conrad907/DCADesign/Design 2/Design Review Package/Final Design Review Package/Schematics/STLs/Tilt_Motor_Mount_4235323/README.txt

Tilt Motor Mount by ATXHELI on Thingiverse: https://www.thingiverse.com/thing:4235323
