conrad907/DCADesign/Design 1/F22_CPE_4813_Assignment7_SymposiumPoster_Team14 (1).pptx

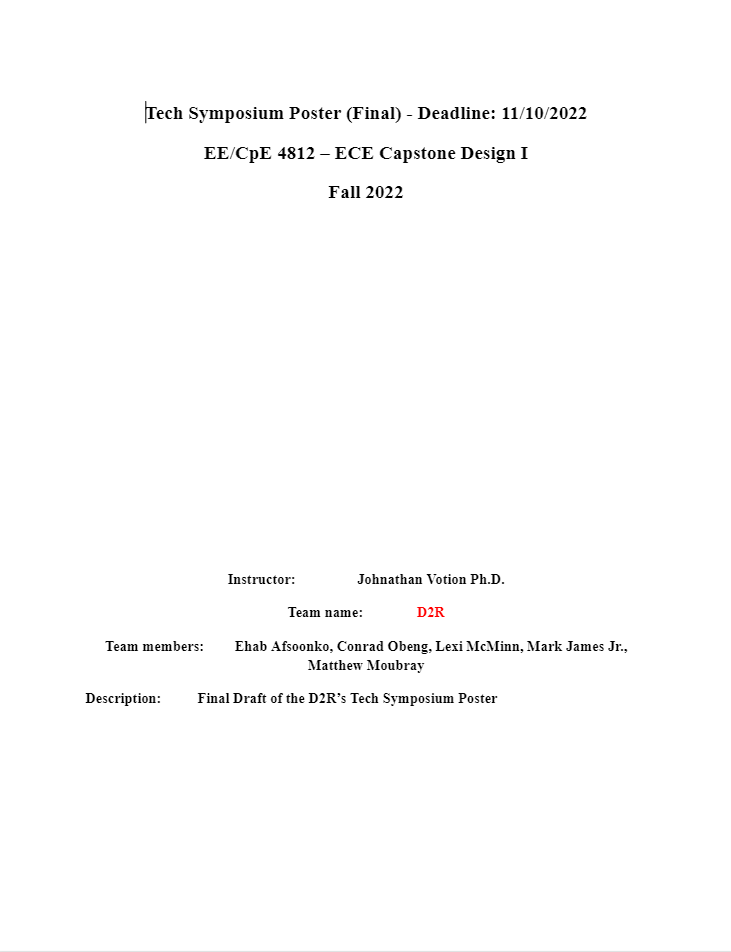
[picture p3: figure]

## Slide 2

Sponsor: USL Lab, UTSA
Ehab Afsoonko, Conrad Obeng, Lexi McMinn, Mark James Jr., Matthew Moubray

Alternative Transportation Modes for UAV Systems

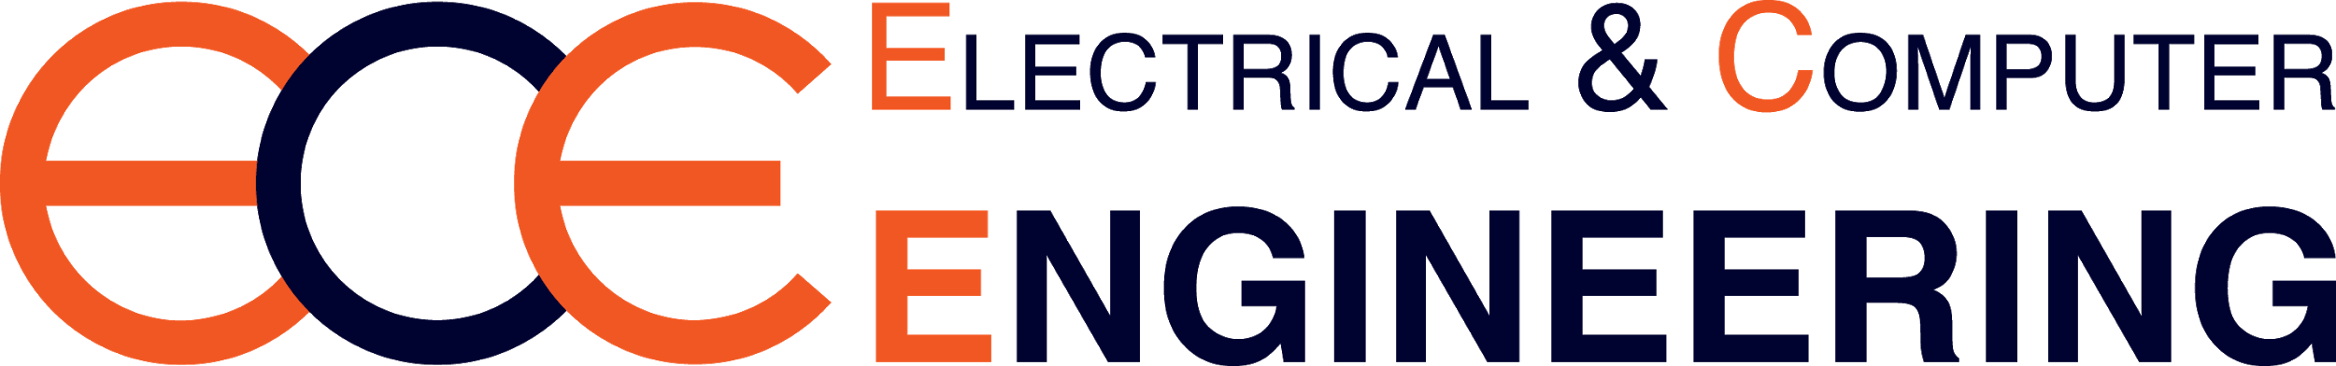
[picture p4: figure]

Abstract

This project aims to expand the number of vehicle transportation modalities traditionally associated with QuadCopter Drones, so that customers are not pigeon-holed into one method of transportation. Specifically, the project aims to bring VTOL Fixed-Wing and Rover transportation modes to a drone, allowing for longer flight times with less battery, and ground-based transportation, respectively.

Functional Block Diagram

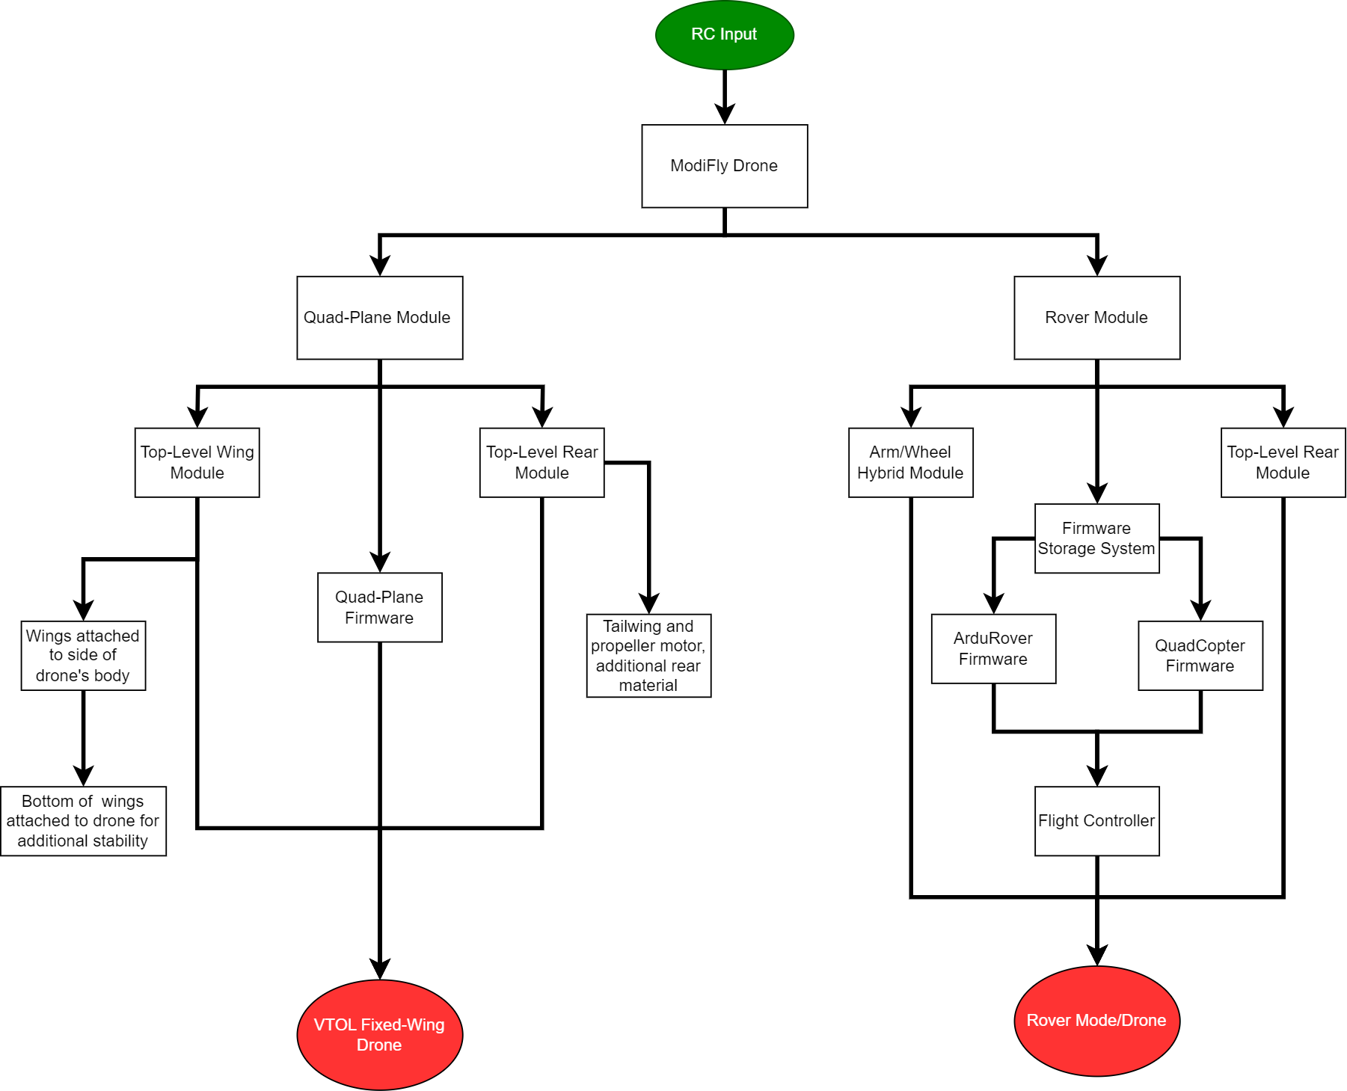
[picture p5: figure]

Components

- Flywoo Goku F745 Flight Controller
- ModiFly Drone Platform
- VTOL Fixed-Wing Module (Connector, wings, propeller, etc)
- Rover Module (Connector, wheels, etc)

Work Breakdown Structure

1. Month 1 - November:
  1. Download and familiarize with flight controller firmware
  2. Begin first design of Rover mode modules
2. Month 2 - December/January
  1. Prototype of Rover module
  2. First firmware modification test
  3. Implement Firmware swapping
3. Month 3 - February
  1. Begin prototyping Fixed-wing VTOL & firmware
  2. Continued development of Rover module
4. Month 4 - March
  1. Rover Module in final state, firmware close
  2. Fixed-Wing VTOL development continued
5. Month 5 - April to End
  1. Rover Module with switching capability implemented and fully document
  2. Fixed-wing VTOL module and firmware fully implemented

Need for Product

If an end-user only has a single UAV/UGV/unmanned system, that machine is limited to a single transportation modality. However, having separate re-attachable modules for different movement options allows the operator to change the functionality of the unmanned system without needing to purchase an additional system. Currently, most professional Fixed-Wing VTOL UAVs can cost anywhere from $1,000 to $20,000. By creating a Fixed-Wing VTOL and Rover re-attachable module, we enable the ModiFly Drone to be an extremely versatile and adaptable UAV versus it’s competitors, while also saving the consumer both time and money.

Fig. 7 Function Block Diagram

Design Concept

The goal is to add multiple reattachable-modules to an existing drone framework model with the intent to expand and improve the functionality. The primary module will add rover functionality that allows the drone to be able to land and switch to a ground-based transportation mode. The Rover module should be able to switch modes without needing the operator to be in close proximity, as well as preserve the flight or drive data between mode switches. The current solution is to design a new arm module that replaces the previous feet with a wheel, axle, and transmission assembly without adding too much weight to interfere with the flight capabilities. The second module will be a Fixed-Wing module that will allow for increased flight duration while retaining the Vertical Take-off and Landing capabilities already present on the base drone.
Major Features
- Air and ground transportation modes without operator’s physical interaction
- Fixed-wing VTOL Module
- Foldable wing design for Rover mode
- Flight/drive data consistency between mode changes

Software Flowchart

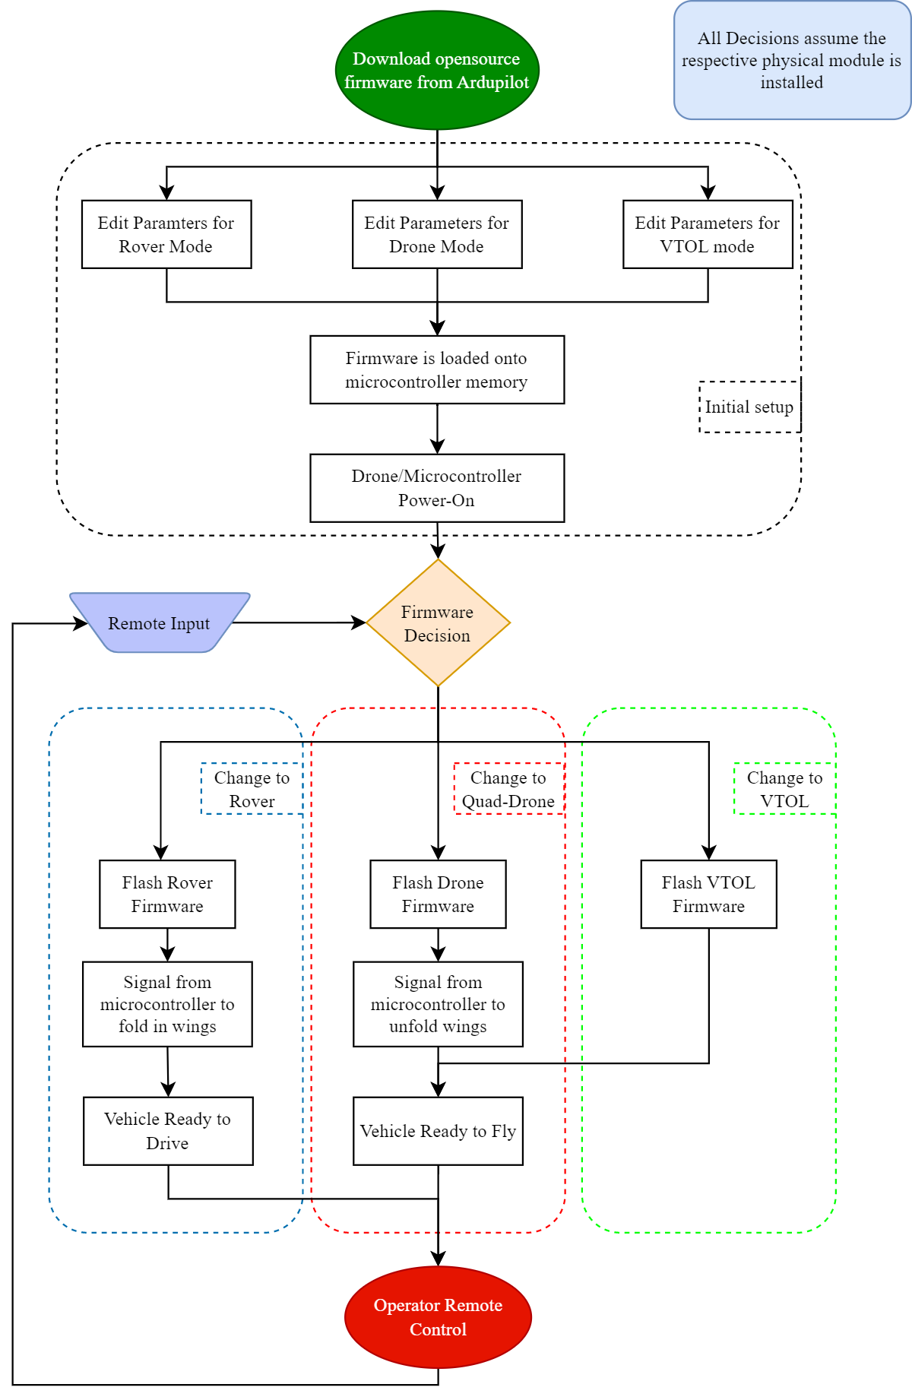
[picture p6: figure]
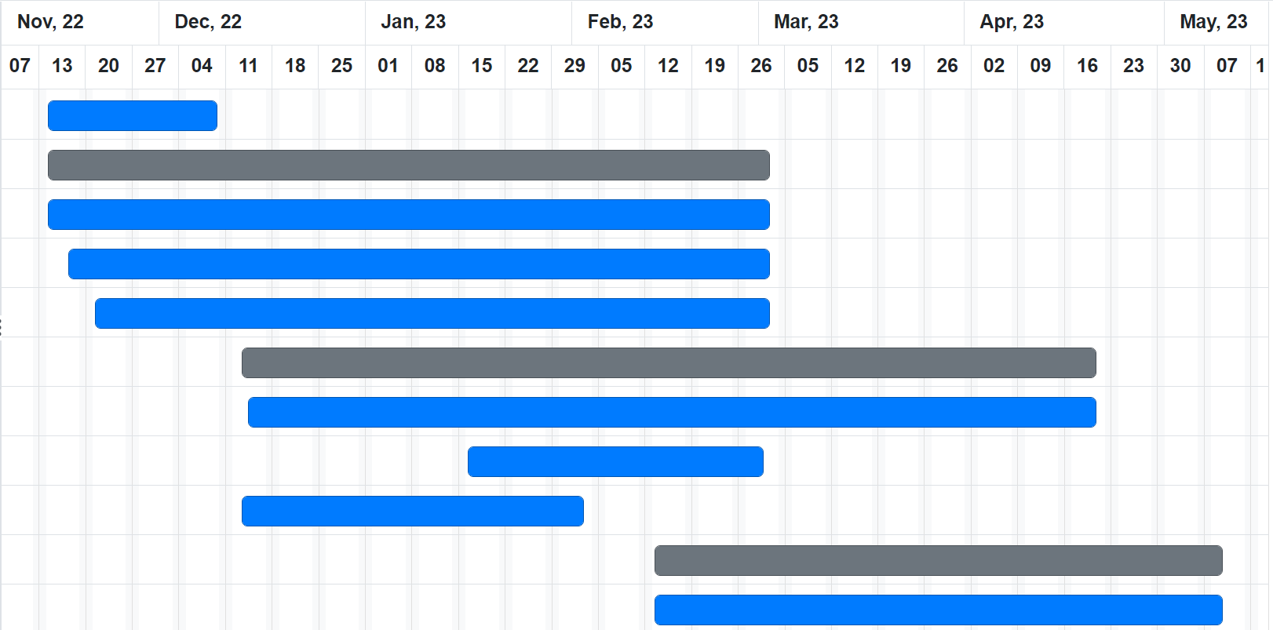
[picture p7: figure]
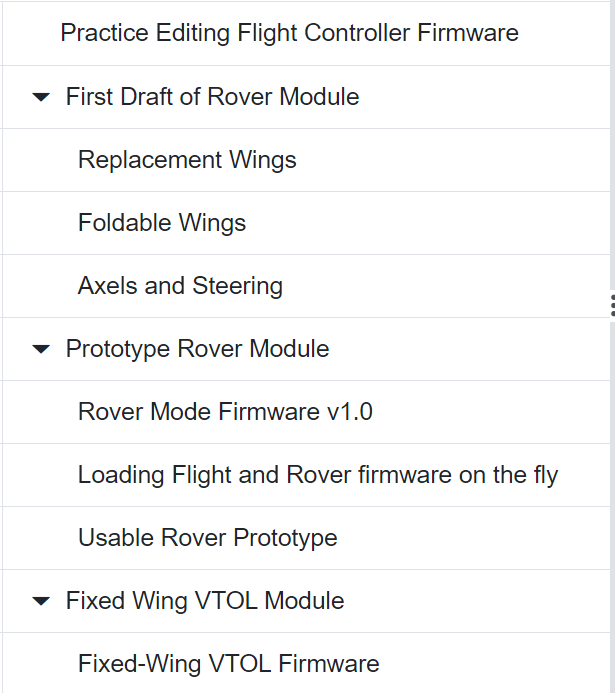
[picture p8: figure]

Fig. 9 Gantt Chart

Picture References

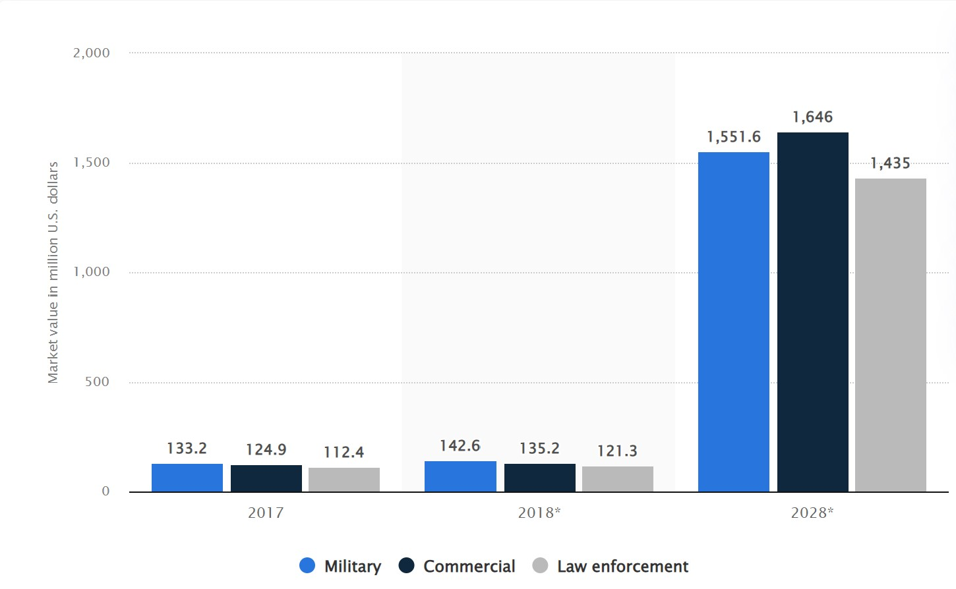
[picture p9: figure]

Fig. 1 Size of the global fixed-wing hybrid vertical take-off and landing (VTOL) UAVs market from 2017 to 2028, by end-user

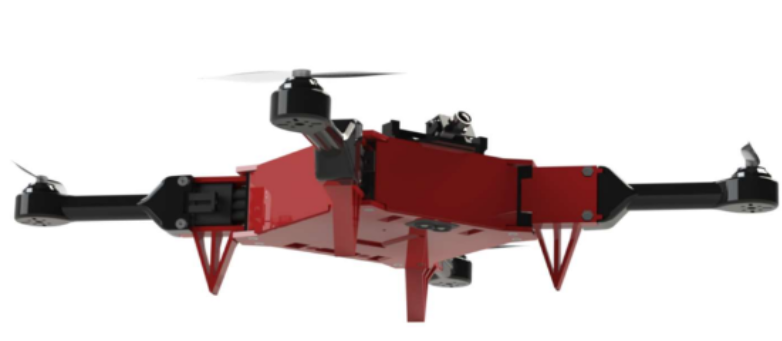
[picture p10: figure]

Fig. 2 Image of the ModiFly Drone platform

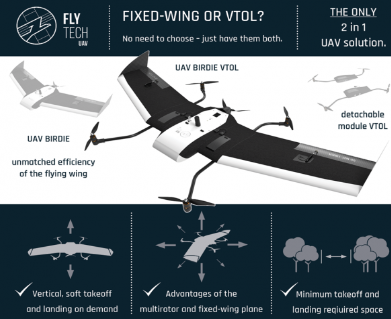
[picture p11: figure]
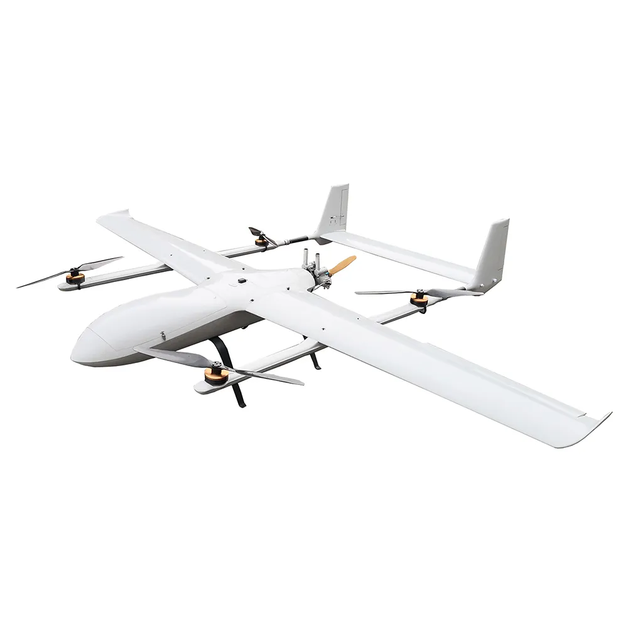
[picture p12: figure]

Acknowledgments

The Drone To Rover(D2R) team would like to give a special thanks to Dr. Yongcan Cao, ECE, USL Lab, UTSA, and Josh Barron for the technical and financial support of our project. We would also like to recognize the UTSA Makerspace, Student Success Center, and the UTSA ECE department faculty and staff for providing the resources, instruction and support related to this project.

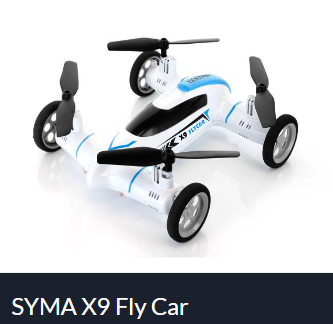
[picture p13: figure]

Fig. 3 (top) Flytech Birdie VTOL Module

Fig. 4 (bottom) SYMA X9 Fly Car

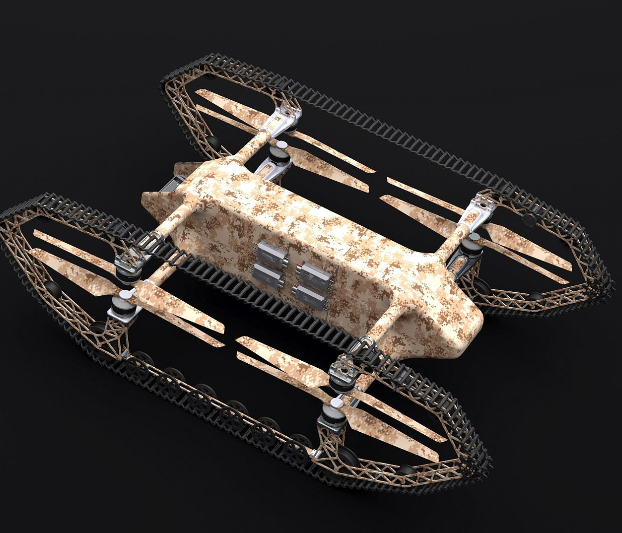
[picture p14: figure]

Fig. 5 (top) VTOL Fixed-Wing Drone

Fig. 6 (bottom) HUUVER Hybrid Drone

Fig. 8 Software Flowchart

## Slide 3

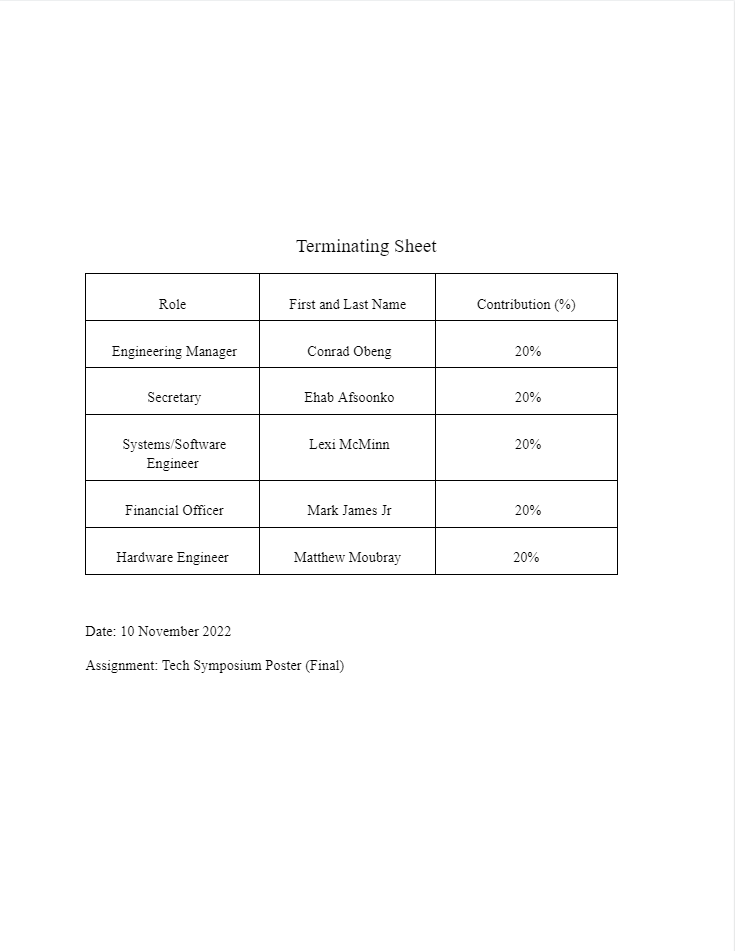
[picture p15: figure]
