conrad907/DCADesign/Design 2/Design Review Package/Final Design Review Package/Schematics/Copy of Airframe Schematic.pptx

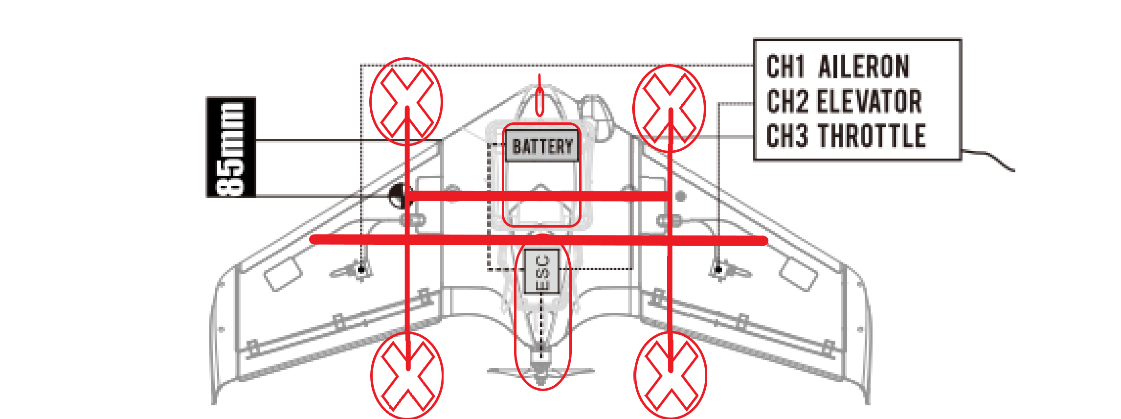
[picture p16: figure]

Team Design Additions
1. Propeller and boom assembly
2. Airspeed Sensor
3. ModiFly Base insert
4. Carbon Fiber poles and boom assembly joint connection
5. Carbon Fiber Poles for wing stability
6. Forward Propulsion ESC
7. Forward Propulsion Propellor

1.

2.

3.

4.

5.

6.

7.

## Slide 2

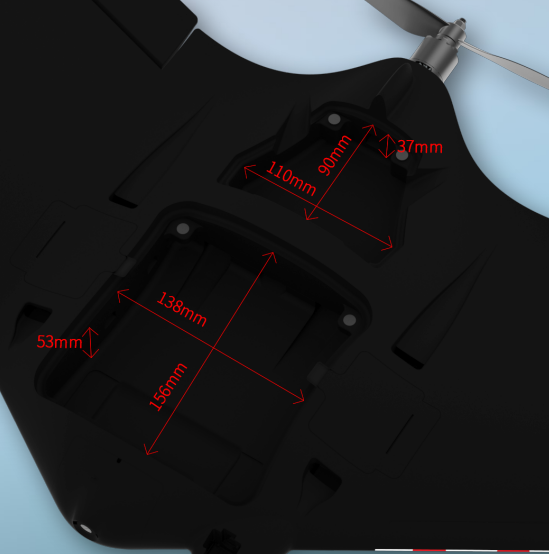
[picture p17: figure]
