conrad907/DCADesign/Cover Page.docx

DCA Project File

EE/CpE 4813 – ECE Capstone Design 2

Spring 2023

Instructor: Johnathan Votion Ph.D. & Professor August Allo

Team name: Drone Conversion Appliances (DCA)

Team members: Ehab Afsoonko, Conrad Obeng, Lexi McMinn, Mark James Jr., Matthew Moubray

Description: Folder Structure System for Design 1 and Design 2 Documentation
