conrad907/DCADesign/Design 1/Assignments/ArduRover High-Level Diagram.drawio (1).pdf

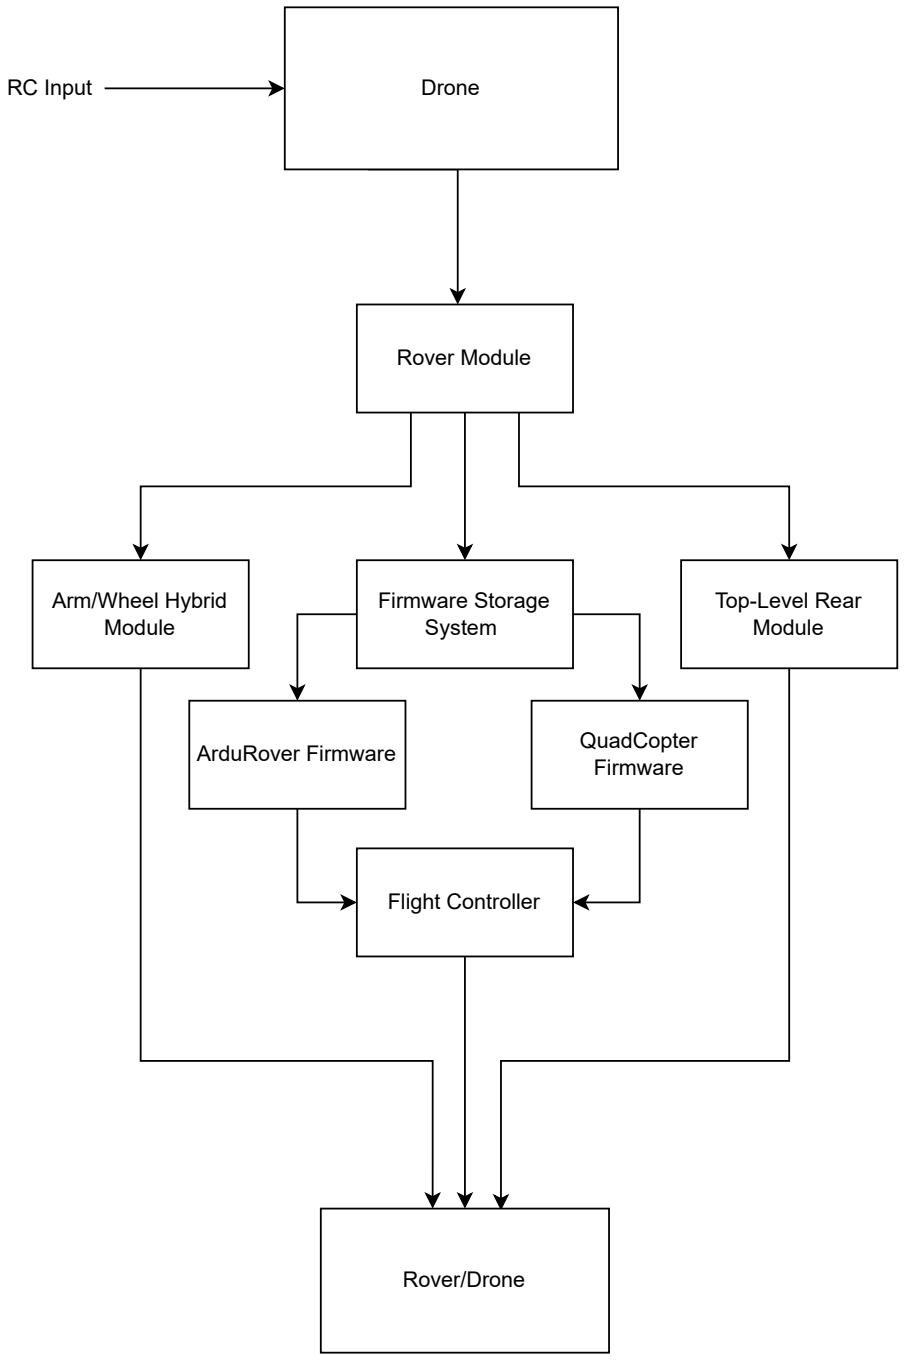
[picture p55: figure]
RC Input; Drone; Rover Module; Arm/Wheel Hybrid Module; Top-Level Rear Module; Flight Controller; Rover/Drone; Firmware Storage System; ArduRover Firmware; QuadCopter; Firmware
