conrad907/DCADesign/Design 1/Assignments/Assignment 4 Block Diagram.drawio (1).pdf

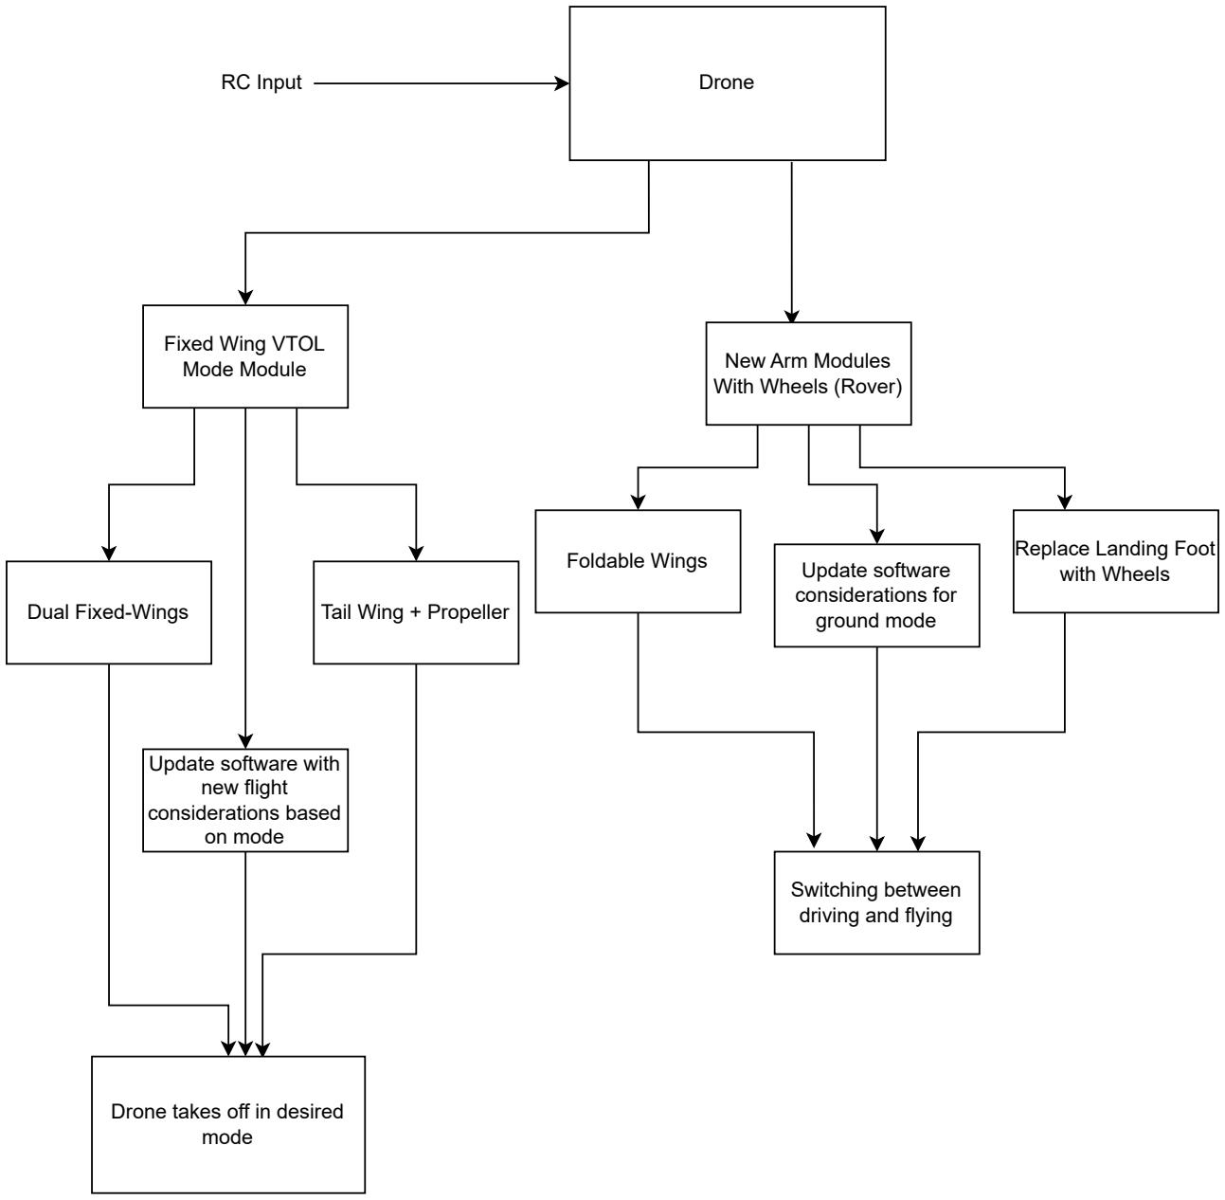
[picture p56: figure]
RC Input; Drone; Foldable Wings; New Arm Modules With Wheels (Rover); Fixed Wing VTOL Mode Module; Replace Landing Foot with Wheels; Switching between driving and flying; Dual Fixed-Wings; Tail Wing + Propeller; Update software with new flight considerations based on mode; Update software considerations for ground mode; Drone takes off in desired mode
