conrad907/DCADesign/Design 1/Assignments/Assignment 4 Level 1.drawio (1).pdf

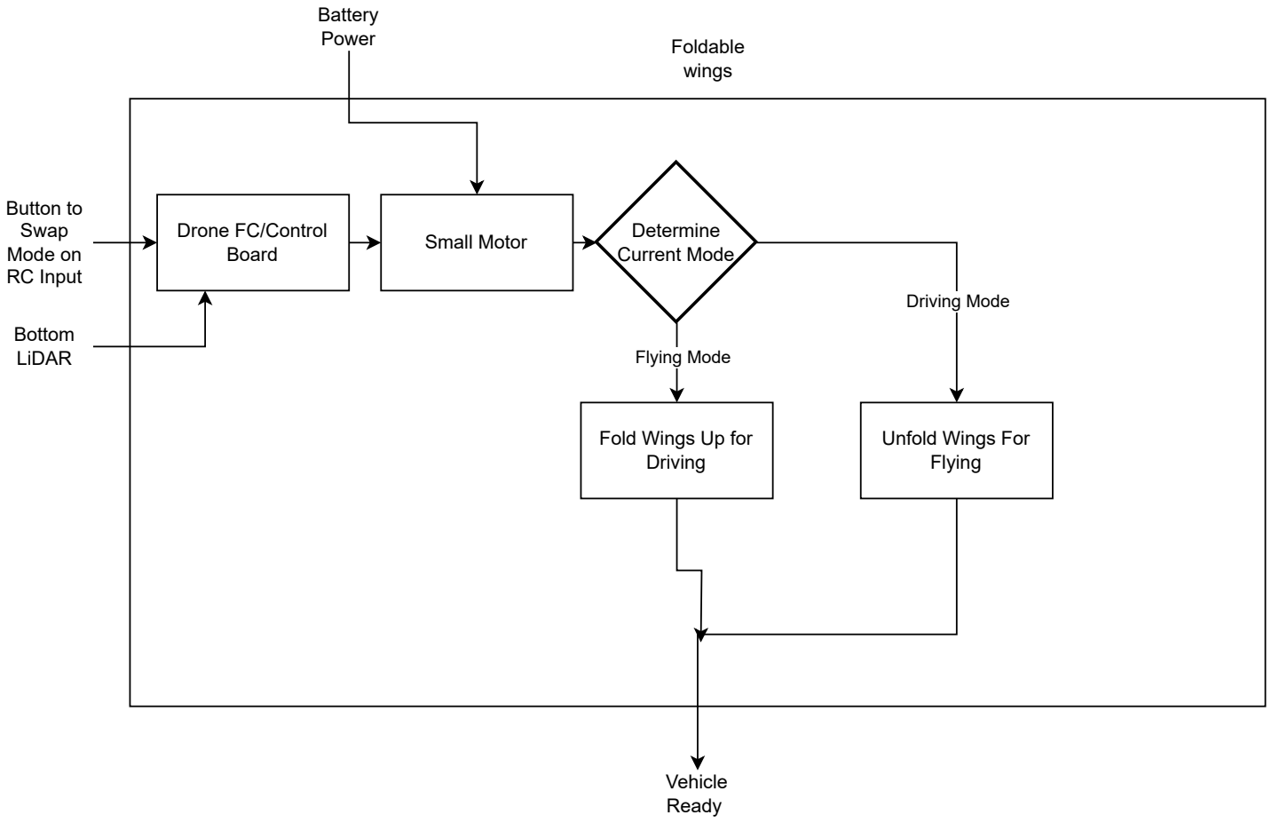
[picture p57: figure]
Foldable wings; Small Motor; Button to Swap Mode on RC Input; Flying Mode; Driving Mode; Fold Wings Up for Driving; Determine Current Mode; Unfold Wings For Flying; Vehicle Ready; Battery Power; Drone FC/Control Board; Bottom LiDAR
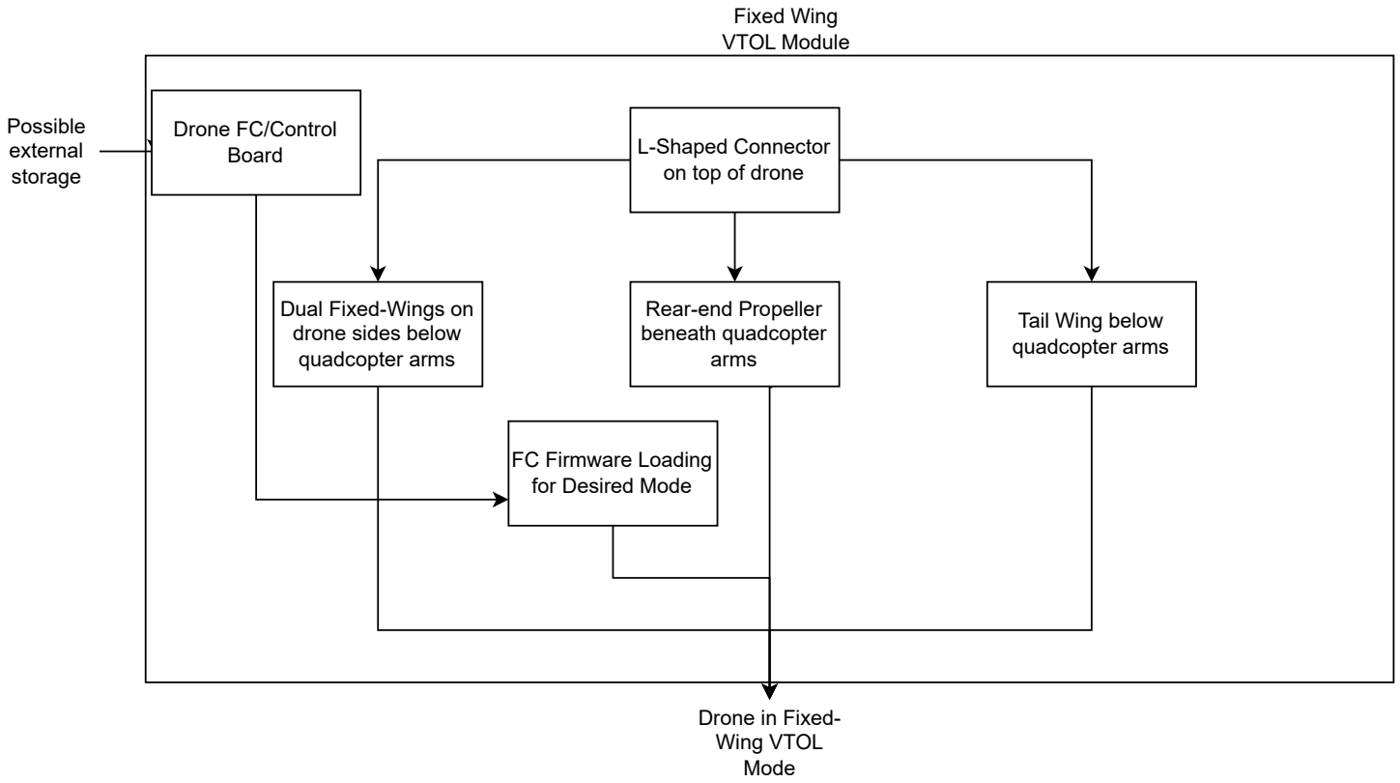
[picture p58: figure]
Fixed Wing VTOL Module; L-Shaped Connector on top of drone; Dual Fixed-Wings on drone sides below quadcopter arms; Rear-end Propeller beneath quadcopter arms; Tail Wing below quadcopter arms; FC Firmware Loading for Desired Mode; Drone in Fixed- Wing VTOL Mode; Possible external storage; Drone FC/Control Board
