conrad907/DCADesign/Design 2/Design Review Package/Critical Design Review Package/Schematics/ModiFly Drone Base.drawio.pdf

150 mm

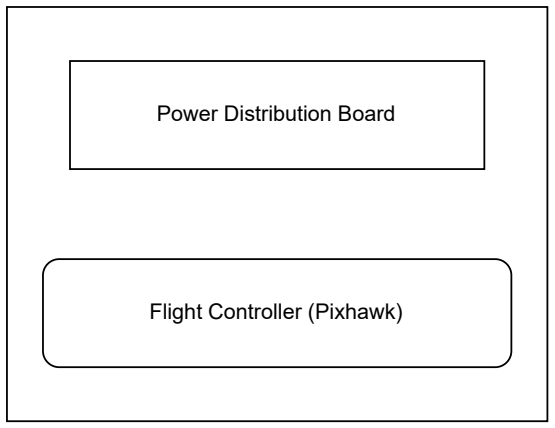
[picture p71: figure]
Flight Controller (Pixhawk); Power Distribution Board

115 mm

150 mm

115 mm

LiDAR

Middle Connector

ESC

Radio
Transmitter

Battery Pack

Battery Pack

2 mm 2 mm

60 mm

Pixhawk

24 mm

16 mm

15 mm
empty
space
Top Plate | Bottom Plate

# Side View

Top Plate

Bottom Plate
