conrad907/DCADesign/Design 2/Design Review Package/Final Design Review Package/Schematics/ModiFly Drone Base.drawio.pdf

115 mm

## 3300mAH 4S Battery Pack

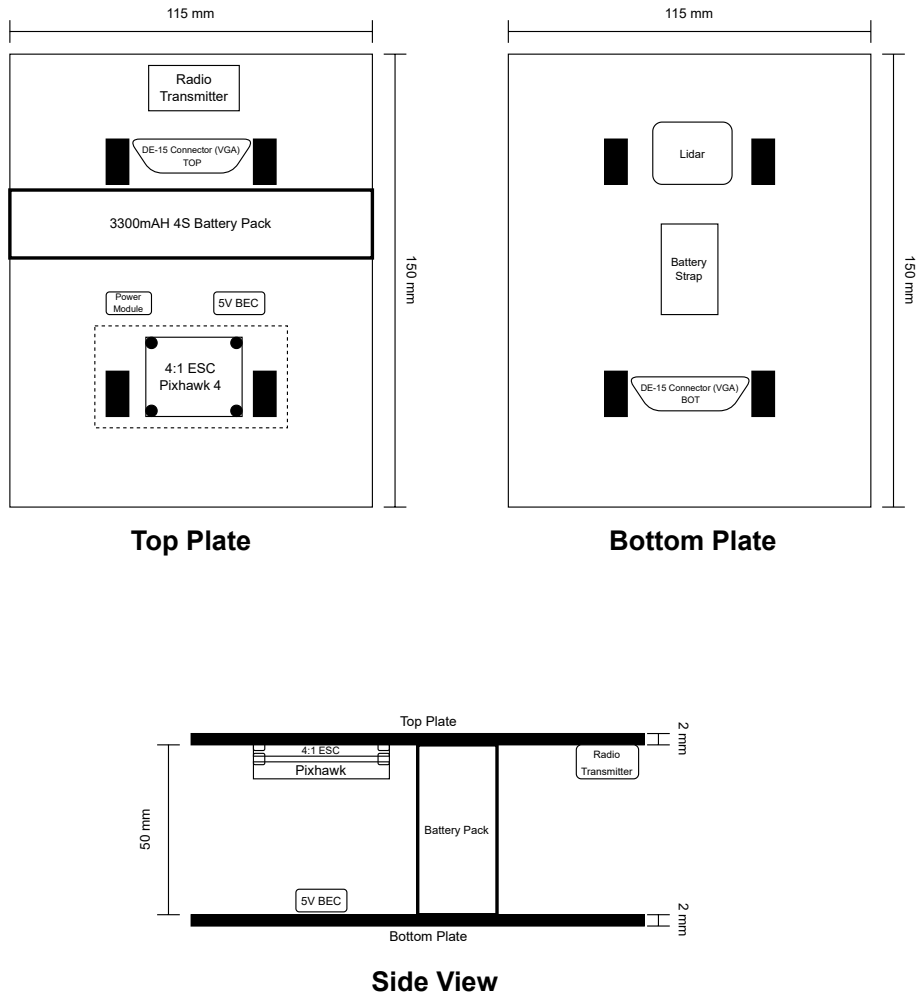
[picture p72: page 1]
Pixhawk; Top Plate; Bottom Plate; Side View; 4:1 ESC Pixhawk 4; Radio Transmitter; Lidar; Battery Strap; 5V BEC; Battery Pack; 4:1 ESC; Radio; Transmitter; TOP; BOT; Power Module

DE-15 Connector (VGA)

## Pixhawk

## 3300mAH 4S Battery Pack

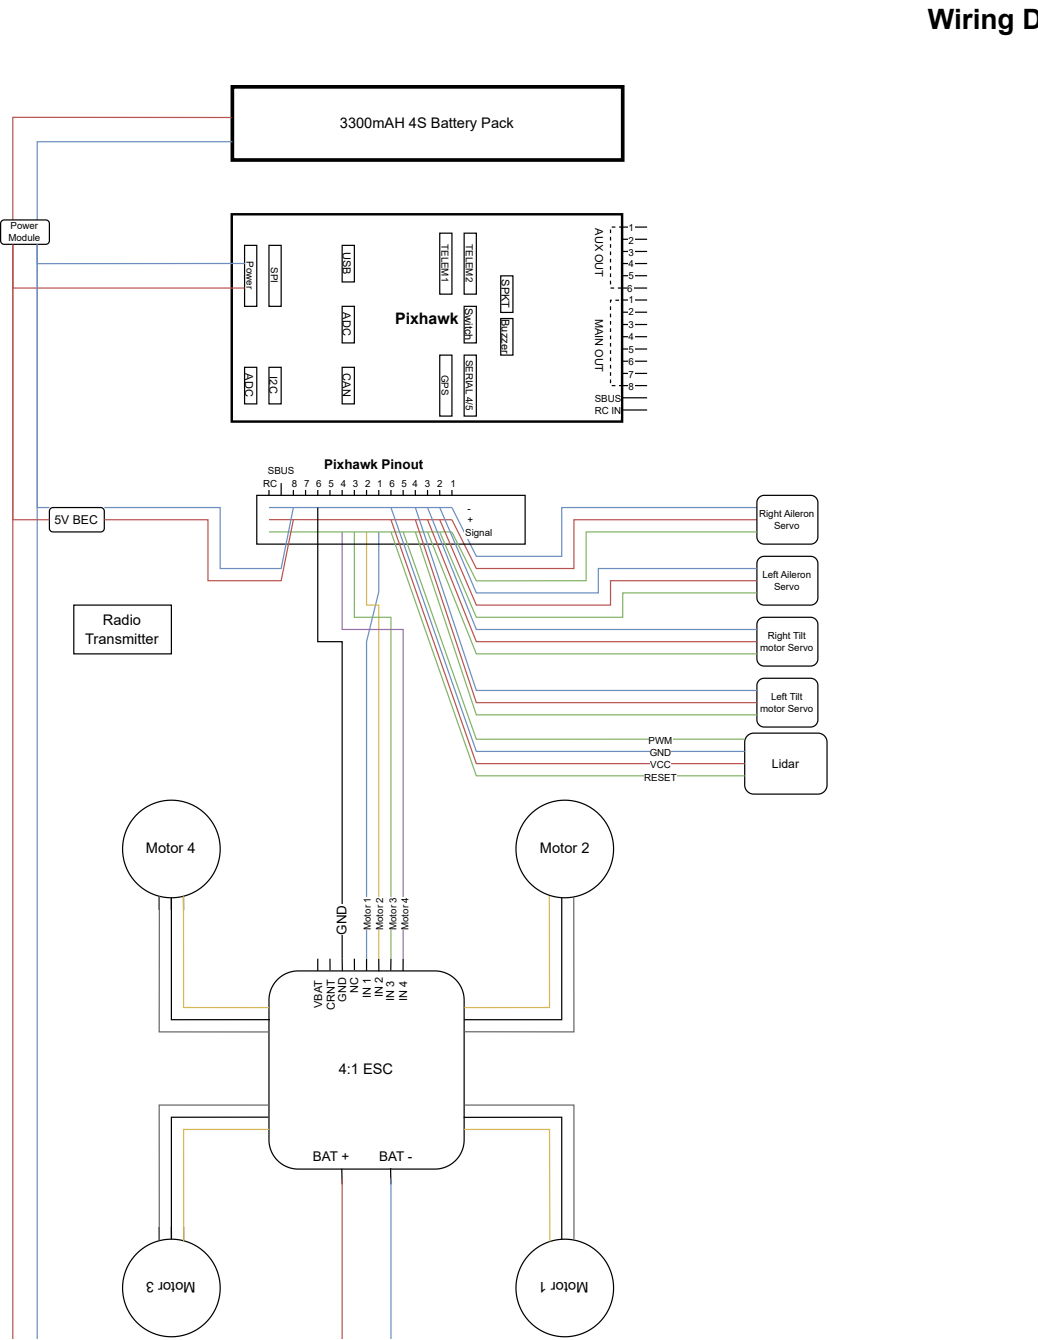
[picture p73: page 3]
SBUS; Power; USB; Switch; TELEM1; TELEM2 SERIAL 4/5; ADC CAN; SPKT Buzzer; ADC; GPS; SPI; Left Tilt motor Servo; 4:1 ESC; Right Tilt motor Servo; Motor 4; Wiring D; Motor 2; Left Aileron Servo; Right Aileron Servo; Radio Transmitter; 5V BEC; BAT +; BAT - VBAT CRNT GNDNC IN ¹ IN ² IN ³ IN ⁴ Motor 1 Motor 2 Motor 3 Motor 4; - + Signal; SBUS RC; GND; Power Module; Lidar; PWM; VCC RESET; Pixhawk Pinout

AUX OUT MAIN OUT

# Diagram

DE-15 Connector (VGA)
TOP

DE-15 Connector (VGA)
BOT

5V
RX4

## Pixhawk

8

7

6

RC IN

SBUS

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
Power

USB

Switch

TELEM1

TELEM2 SERIAL 4/5

ADC CAN

SPKT Buzzer

ADC
I2C

GPS

SPI

AUX OUT MAIN OUT

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
## Pixhawk

8

7

6

RC IN

SBUS

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
Power

USB

Switch

TELEM1
TELEM2 SERIAL 4/5

ADC CAN

SPKT Buzzer

ADC
I2C

GPS

SPI

AUX OUT MAIN OUT

5V TX
GND RX

PWM
