conrad907/DCADesign/Design 2/Design Review Package/Critical Design Review Package/Schematics/Ecalc Snapshot.png

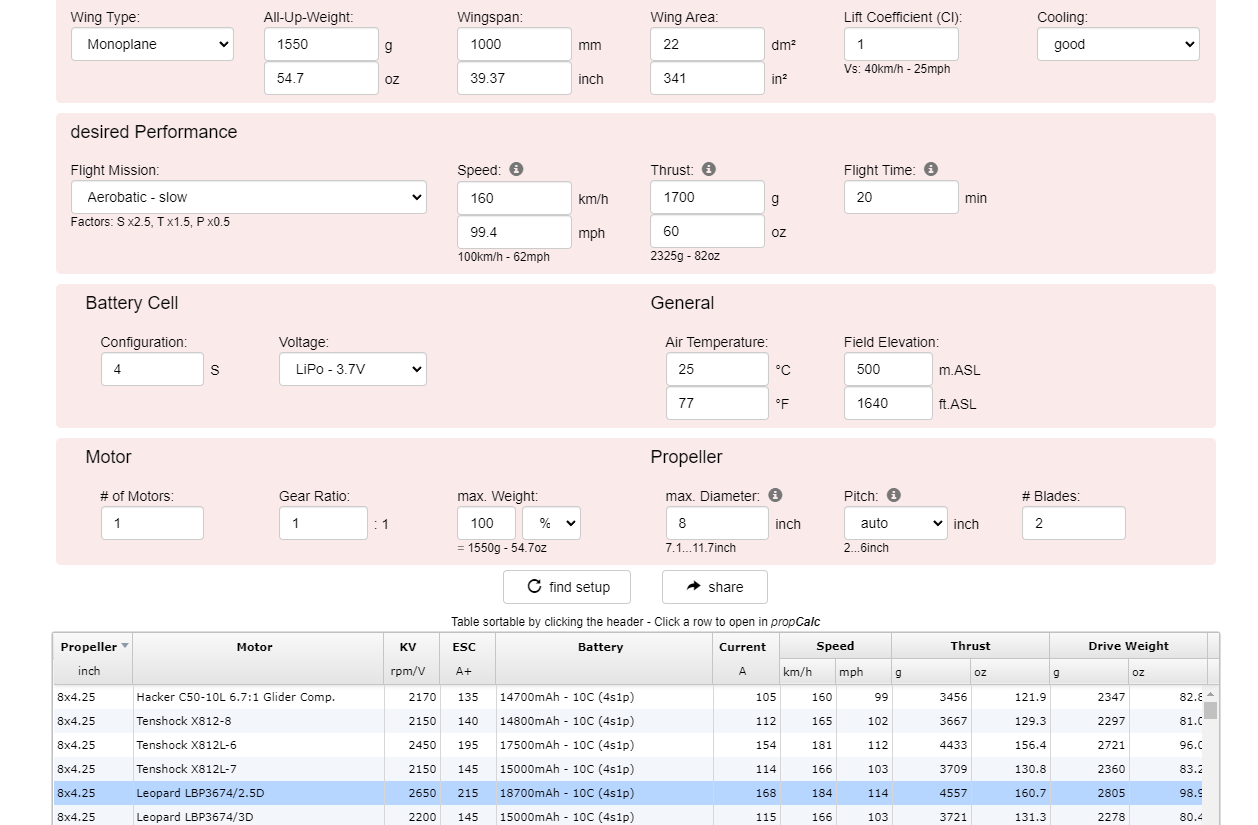
Design 2/Design Review Package/Critical Design Review Package/Schematics/Ecalc Snapshot.png
