conrad907/DCADesign/Design 2/Design Review Package/Final Design Review Package/Schematics/Project Images/Copy of PXL_20230405_212054750.jpg

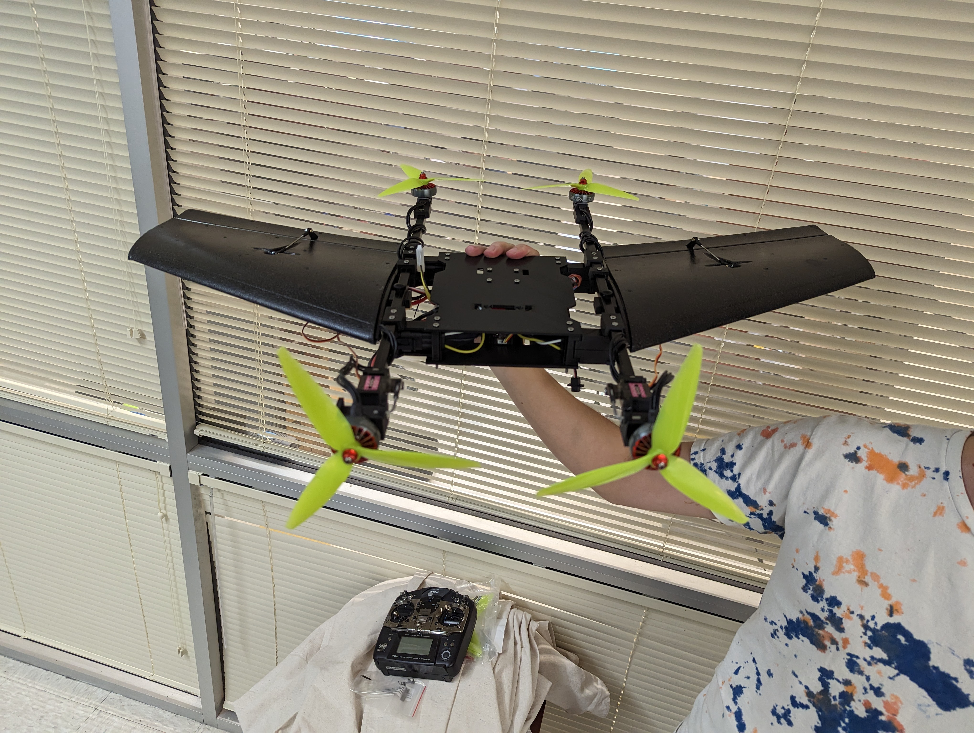
Design 2/Design Review Package/Final Design Review Package/Schematics/Project Images/Copy of PXL_20230405_212054750.jpg
