conrad907/DCADesign/Design 2/Design Review Package/Final Design Review Package/Schematics/Project Video Documentation/PXL_20230414_205604099.jpg

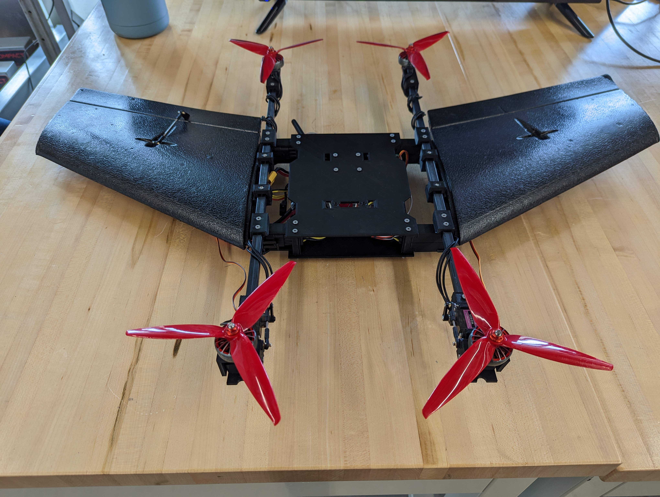
Design 2/Design Review Package/Final Design Review Package/Schematics/Project Video Documentation/PXL_20230414_205604099.jpg
