conrad907/DCADesign/Design 2/Design Review Package/Final Design Review Package/Schematics/STLs/Tilt_Motor_Mount_4235323/images/featured_preview_IMG_1219.JPG

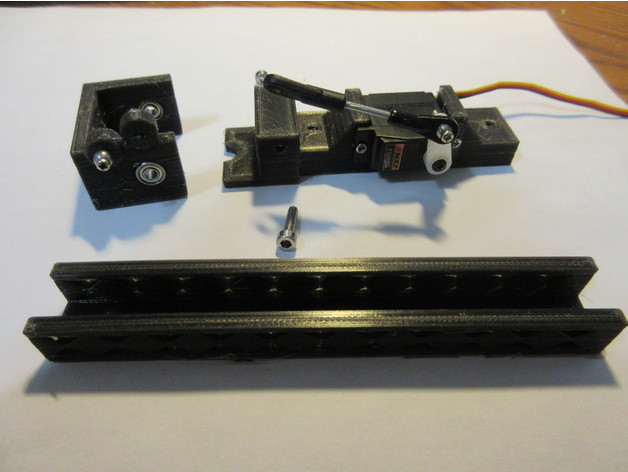
Design 2/Design Review Package/Final Design Review Package/Schematics/STLs/Tilt_Motor_Mount_4235323/images/featured_preview_IMG_1219.JPG
