conrad907/DCADesign/Design 2/Design Review Package/Final Design Review Package/Major Components/Major Components List Updated.docx

Major Components List

1. VTOL Wings: SonicModell AR WING PRO Wings
  a. The SonicModell AR Wing Pro wings were selected for their large wing spans and aerodynamic stability, enabling our design to have an increased carrying capacity. In addition, the length of these wings fit well with the current ModiFly design.
  b. How much Payload can our plane hold? (60-70g / dm²)
  c. SonicModell Wing Area ~28 dm^2
    i. Wing Area (WA)=(Root Chord + Tip Chord)/2 x Wing Span (WS)
    ii. Estimated Root Chord = 268 mm
    iii. Estimated Tip Chord = 170 mm
    iv. Wing Span = 1000mm
  d. Estimated 1680-1960g payload capacity
2. VTOL Propellors and motors: iFlight Xing-E Pro 2207 (4pcs) and 7-inch Tri-Blade Propellers (4pcs)
  a. These motors were chosen for their high speed and lift capacity, allowing the heavier Modifly drone base to lift into the air
    i. Base Mounting Pattern: 16x16mm M3 Thread
    ii. Motor Wire Length: 150mm / 20AWG
    iii. Internal Resistance (Rm): 81.5mΩ
    iv. Max Burst Current <10s: 35.22A
    v. Motor Dimension: 28.5x19.7mm
    vi. Idle Current @12.6v (Io): 1.2 A
    vii. Weight: 33.8g (150mm wires)
    viii. Shaft Diameter: 4mm / Steel
    ix. Max Power (W) 60s: 845W
    x. Magnets: N52SH Curved
    xi. Stator Diameter: 22mm
    xii. Configuration: 12N14P
    xiii. Bearing Size: 9x4x4
    xiv. Cells (LiPo): 2-6S
  b. These propellers were chosen due to their lift potential, as well as their balance
3. VTOL Battery: HRB 4S Lipo Battery 3000mAh 14.8V 60C
  a. This battery was chosen for its small height (28mm), while still being a 4S battery. This was due to height limitations on the Modifly Drone base.
    i. Weight: 13.4oz
    ii. 135x42x28mm
4. Flap Servo Motors:
  a. 2pcs 9g metal gear servo
5. VTOL Tilt Motors:
  a. 2pcs 9g metal gear servo
6. Carbon Fiber Rods:
  a. 10x10x1000mm Carbon Fiber Tubes (4pcs)
7. Modifly Base Components (Total Weight not including 3D printed case ~85.6g)
  a. Flight Controller: PixHawk 4
    i. The flight controller was upgraded from the Flywoo Goku F745 to the PixHawk4 for the extra serial ports needed to control the additional servo motors and additional motors that come with the VTOL module.
    ii. Weight: 15.8g
  b. Power Distribution Board
    i. Weight: ~16g
  c. BEC Component
    i. UBEC Micro 5V/3A Adjustable BEC
  d. Radio Transmitter: Futaba
    i. The Futaba transmitter was selected as it uses the s.bus2 protocol to exchange signals with the radio control receiver. This transmitter is also small and lightweight
    ii. 2.4GHz signals
    iii. 8/32 Channels
    iv. Size: 0.98 x 1.86 x 0.56" (24.9 x 47.3 x 14.3mm)
    v. Weight: 10.1g
    vi. Power Requirement: 4.8-7.4V
    vii. Battery F/S Voltage: Sets up with a transmitter.
    viii. Extra Voltage Port: 0 ~ 70V DC
  e. I2C Splitter Module: Smakn Pixhawk I2C
    i. 5 parallel I2C connections
    ii. 4-bit socket
    iii. Weight: ~5g
  f. LiDar : TF-Luna LiDAR single-point ranging module
    i. The LiDar has obstacle avoidance built into the code. This provided the ModiFly Drone 8m of object detection for a low cost.
    ii. Detecting Range: 0.2m~8m
    iii. Field of View: 2°
    iv. Supply Voltage: 5V±0.1V
    v. Frequency: 100Hz
    vi. Data Interface: UART/I2C
    vii. Weight: 5g
  g. Bluetooth Module
    i. The bluetooth module is small and lightweight keeping the overall weight of the Modifly down without taking up necessary space for larger components.
    ii. Size: 37.5 x 16.5 x 4.4mm
    iii. Weight: 10.1g
    iv. Power Requirement: 4.8-7.4V
  h. 4in1 ESC: HAKRC 45A 2-6S BLHeli_S 4in1 ESC
    i. The HAKRC ESC was chosen due to the PixHawk 4 not having a built in 4in1 ESC like the Flywoo Goku needed to control the VTOL motors.
    ii. Weight: 13.6g

LINKS TO PURCHASED ITEMS:

- Wing Kit: https://www.amazon.com/SonicModell-AR-Wing-Pro-Main-Wing/dp/B08XBLV5PL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 (https://nam11.safelinks.protection.outlook.com/?reserved=0)
- Digital Servo Motors: https://www.amazon.com/4-Pack-MG996R-Torque-Digital-Helicopter/dp/B07MFK266B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 (https://nam11.safelinks.protection.outlook.com/?reserved=0)
- Ball Bearings: https://www.amazon.com/uxcell-Groove-Bearings-Double-Shielded/dp/B0819B49JY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 (https://nam11.safelinks.protection.outlook.com/?reserved=0)
- iFlight Motors: https://www.amazon.com/iFlight-2806-5-Brushless-Quadcopter-Unibell/dp/B086MQ3C3B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 (https://nam11.safelinks.protection.outlook.com/?reserved=0)
- 3300mAh Battery: https://www.amazon.com/HRB-3000Mah-Battery-Airplane-Traxxas/dp/B06XKNM73N/ref=psdc_2234134011_t5_B08NDV319J (https://nam11.safelinks.protection.outlook.com/?reserved=0)
- Carbon Fiber Rods: https://www.amazon.com/dp/B08MZHPPN7?ref_=cm_sw_r_apan_dp_MHA3570KRC3GT29Q7KT5 (https://nam11.safelinks.protection.outlook.com/?reserved=0)
