conrad907/DCADesign/Design 2/Design Review Package/Critical Design Review Package/Major Components/Major Components List.docx

Major Components List and the engineering analysis for their selection process.

1. Airframe: SonicModell AR WING PRO
  a. The SonicModell was selected as because the larger wing span and increase wing area enabled our design to have a higher carrying capacity needed with the additional weight being added. In addition, this specific airframe has a large enough cargo space that could house the ModiFly Base without significant restructuring.
  b. How much Payload can our plane hold? (60-70g / dm²)
  c. SonicModell Wing Area ~28 dm^2
    i. Wing Area (WA)=(Root Chord + Tip Chord)/2 x Wing Span (WS)
    ii. Estimated Root Chord = 268 mm
    iii. Estimated Tip Chord = 170 mm
    iv. Wing Span = 1000mm
  d. Estimated 1680-1960g payload capacity
  e. Empty Kity Weight: 340g
2. VTOL Propellors and motors: iFlight Xing-E Pro 2207(4pcs)
  a. Base Mounting Pattern: 16x16mm M3 Thread
  b. Motor Wire Length: 150mm / 20AWG
  c. Internal Resistance (Rm): 81.5mΩ
  d. Max Burst Current <10s: 35.22A
  e. Motor Dimension: 28.5x19.7mm
  f. Idle Current @12.6v (Io): 1.2 A
  g. Weight: 33.8g (150mm wires)
  h. Shaft Diameter: 4mm / Steel
  i. Max Power (W) 60s: 845W
  j. Magnets: N52SH Curved
  k. Stator Diameter: 22mm
  l. Configuration: 12N14P
  m. Bearing Size: 9x4x4
  n. Cells (LiPo): 2-6S
3. VTOL Battery: Zeee 4S Lipo Battery 2200mAh 14.8V 100C
  a. Weight: 185g
4. Forward Propulsion Propellor and motor: Leopard LBP3674 / 2.5D
  a. The Leopard motor was selected with the combination of the ZTW ESC and a 8x4.25 inch propellor to provide enough forward thrust to comfortably fly with the additional weight. Ecalc was used with the airframes specifications and the payload capacity to determine the necessary motor/ESC/prop combo.
  b. Weight: 315g
5. Forward Propulsion ESC: ZTW Mantis 85A ESC
  a. Length: 47mm / 1.85in
  b. Width: 35mm / 1.37in
  c. Height: 15mm / 0.59in
  d. Weight: 57g
6. Forward Propulsion Battery: Zeee 4S Lipo Battery 6000mAh 14.8V 100C
  a. Weight 580g
7. Airspeed Sensor: Matek Digital Airspeed Sensor ASPD-4525
  a. The Matek airspeed sensor was selected due to its compatibility with ardupilot software. The sensor is needed to avoid stalling the aircraft and monitor its current speed.
  b. Weight: 3.5g
8. Flap Servo Motors:
  a. 2pcs 9g metal gear servo
9. Modifly Base Components (Total Weight not including 3D printed case ~85.6g)
  a. Flight Controller: PixHawk 4
    i. The flight controller was upgraded from the Flywoo Goku F745 to the PixHawk4 for the extra serial ports needed to control the additional servo motors and additional motors that come with the VTOL module.
    ii. Weight: 15.8g
  b. Power Distribution Board
    i. Weight: ~16g
  c. Radio Transmitter: Futaba
    i. The Futaba transmitter was selected as it uses the s.bus2 protocol to exchange signals with the radio control receiver. This transmitter is also small and lightweight
    ii. 2.4GHz signals
    iii. 8/32 Channels
    iv. Size: 0.98 x 1.86 x 0.56" (24.9 x 47.3 x 14.3mm)
    v. Weight: 10.1g
    vi. Power Requirement: 4.8-7.4V
    vii. Battery F/S Voltage: Sets up with a transmitter.
    viii. Extra Voltage Port: 0 ~ 70V DC
  d. I2C Splitter Module: Smakn Pixhawk I2C
    i. 5 parallel I2C connections
    ii. 4-bit socket
    iii. Weight: ~5g
  e. LiDar : TF-Luna LiDAR single-point ranging module
    i. The LiDar has obstacle avoidance built into the code. This provided the ModiFly Drone 8m of object detection for a low cost.
    ii. Detecting Range: 0.2m~8m
    iii. Field of View: 2°
    iv. Supply Voltage: 5V±0.1V
    v. Frequency: 100Hz
    vi. Data Interface: UART/I2C
    vii. Weight: 5g
  f. Bluetooth Module
    i. The bluetooth module is small and lightweight keeping the overall weight of the modifly down without taking up necessary space for larger components.
    ii. Size: 37.5 x 16.5 x 4.4mm
    iii. Weight: 10.1g
    iv. Power Requirement: 4.8-7.4V
  g. 4:1 ESC: HAKRC 45A 2-6S BLHeli_S 4in1 ESC
    i. The HAKRC ESC was chosen due to the PixHawk 4 not having a built in 4:1 ESC like the Flywoo Goku needed to control the VTOL motors.
    ii. Weight: 13.6g
  h. GPS Module: Goku GM8-5883 v1.0
    i. This GPS module will provide a 2 meter accuracy for outdoor operations and is compatible with the Ardupilot software we are using the firmware. It will allow us to plot flight paths for the drone to fly through autonomously.
    ii. Dimension: 28mm x 28mm x 8.5mm
    iii. Weight: 10g
    iv. Accuracy Position Horizontal: 2.0 m CEP 2D RMS SBAS Enable (Typical Open Sky)
    v. Support Rate: 4800bps to 921600bps, Default 9600bps
    vi. Data Level: TTL or RS-232, Default TTL level
    vii. Data Protocol: NMEA-0183 or UBX, Default NMEA-0183
