conrad907/DCADesign/Design 2/Design Review Package/Final Design Review Package/Schematics/STLs/Tilt_Motor_Mount_4235323/files/PlaneBase.stl

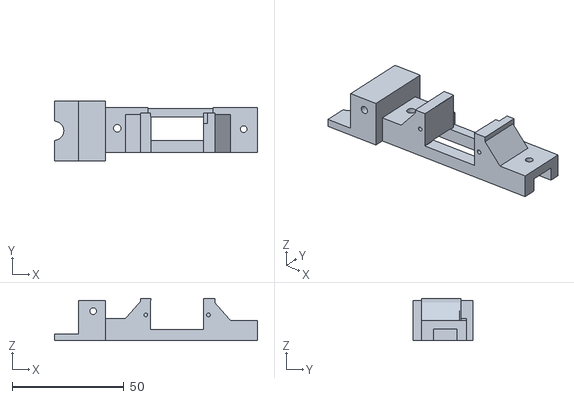
[picture p83: CAD file, 2023-05-08]
Design 2/Design Review Package/Final Design Review Package/Schematics/STLs/Tilt_Motor_Mount_4235323/files/PlaneBase.stl
90.8 x 27.0 x 19.0
