conrad907/DCADesign/Design 2/Design Review Package/Final Design Review Package/Schematics/STLs/vtol WClipSpacer.STL

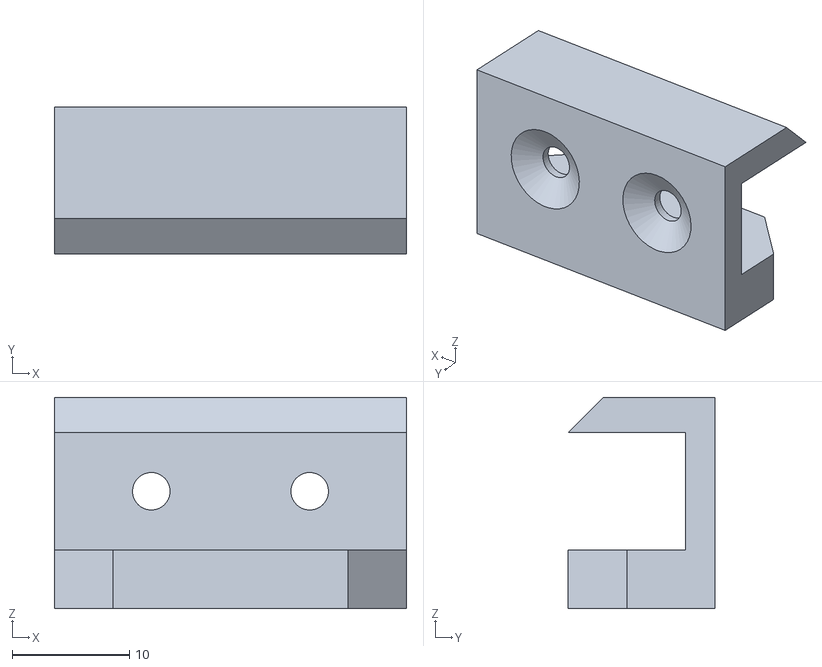
[picture p84: CAD file, 2023-05-08]
Design 2/Design Review Package/Final Design Review Package/Schematics/STLs/vtol WClipSpacer.STL
30.0 x 12.5 x 18.0
