conrad907/DCADesign/Design 2/Design Review Package/Final Design Review Package/Schematics/STLs/vtol Rear motor mount.STL

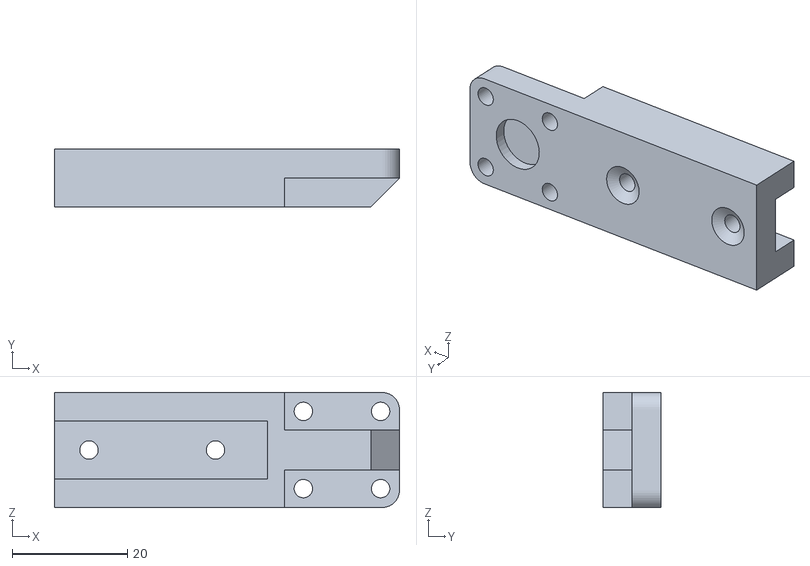
[picture p85: CAD file, 2023-05-08]
Design 2/Design Review Package/Final Design Review Package/Schematics/STLs/vtol Rear motor mount.STL
60.0 x 10.0 x 20.0
