conrad907/DCADesign/Design 2/Design Review Package/Final Design Review Package/Schematics/STLs/Tilt_Motor_Mount_4235323/files/MtrMntPivot.stl

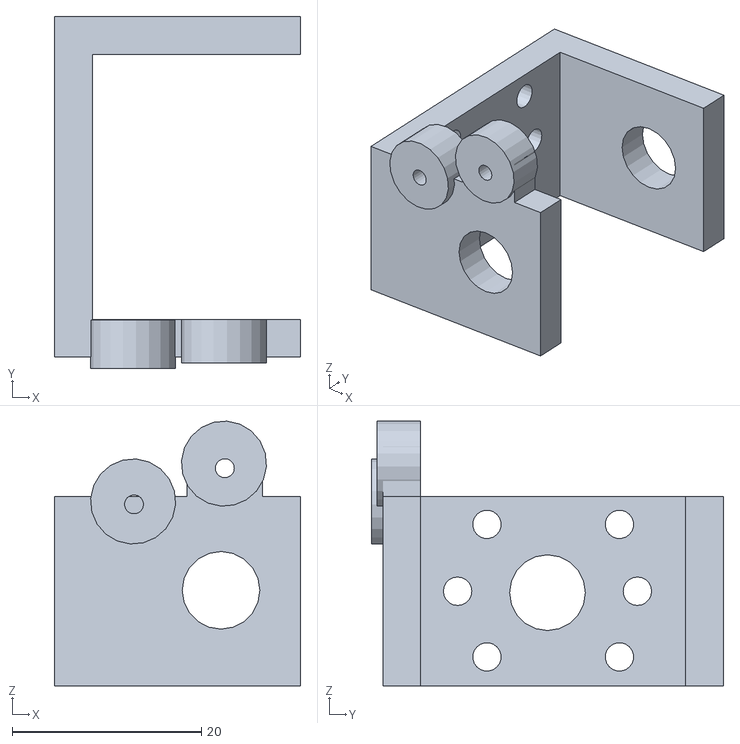
[picture p86: CAD file, 2023-05-08]
Design 2/Design Review Package/Final Design Review Package/Schematics/STLs/Tilt_Motor_Mount_4235323/files/MtrMntPivot.stl
26.0 x 37.2 x 28.0
