conrad907/DCADesign/Design 2/Design Review Package/Final Design Review Package/Schematics/STLs/vtol Rear Bmotor mount.STL

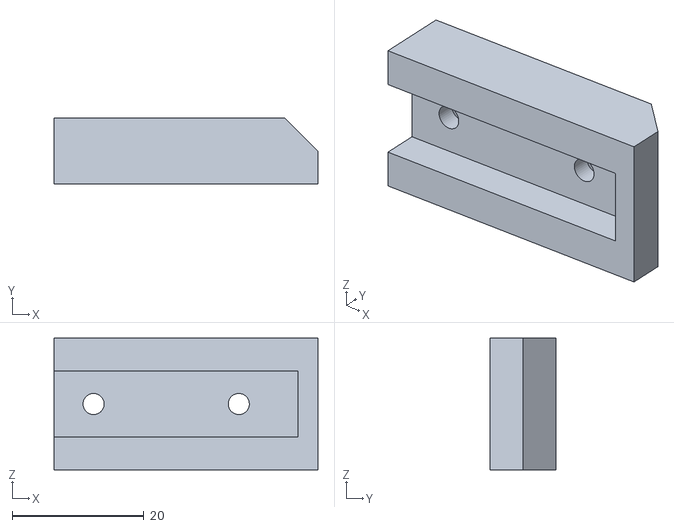
[picture p87: CAD file, 2023-05-08]
Design 2/Design Review Package/Final Design Review Package/Schematics/STLs/vtol Rear Bmotor mount.STL
40.0 x 10.0 x 20.0
