conrad907/DCADesign/Design 2/Design Review Package/Final Design Review Package/Schematics/STLs/vtol BTM plate v8.STL

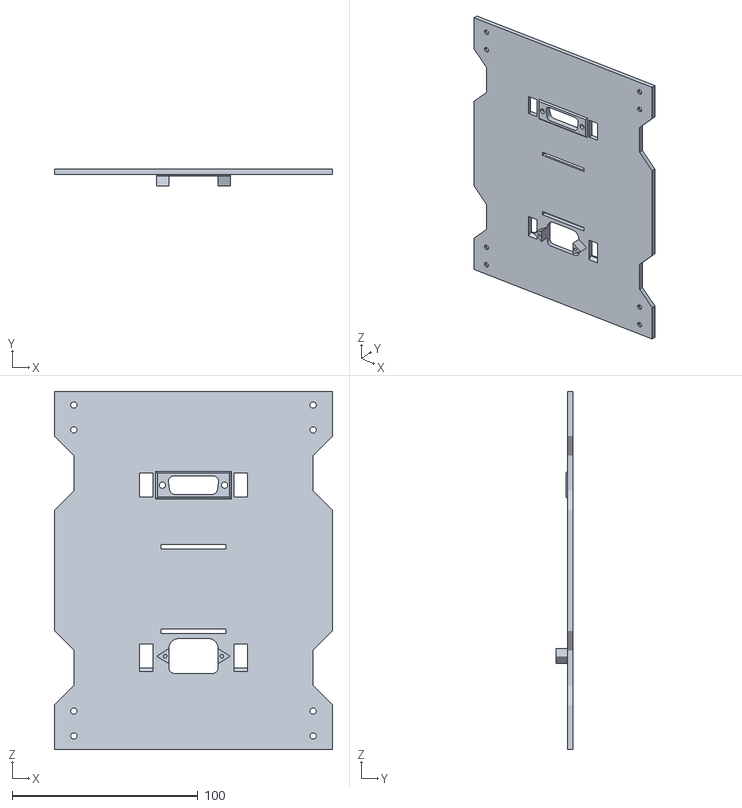
[picture p88: CAD file, 2023-05-08]
Design 2/Design Review Package/Final Design Review Package/Schematics/STLs/vtol BTM plate v8.STL
150.0 x 9.40 x 193.0
