conrad907/DCADesign/Design 2/Design Review Package/Final Design Review Package/Schematics/STLs/vtol wing rod holder.STL

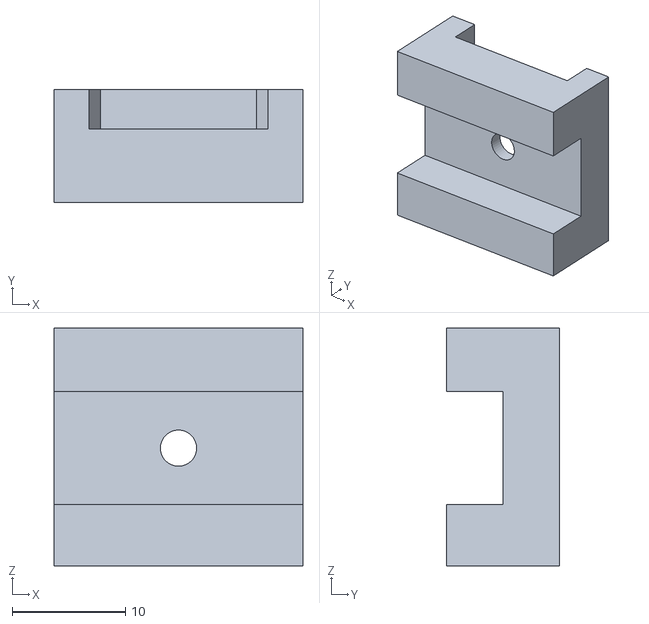
[picture p90: CAD file, 2023-05-08]
Design 2/Design Review Package/Final Design Review Package/Schematics/STLs/vtol wing rod holder.STL
22.0 x 10.0 x 21.0
