conrad907/DCADesign/Design 2/Design Review Package/Final Design Review Package/Schematics/STLs/Tilt_Motor_Mount_4235323/files/MiniTalonSubMount.stl

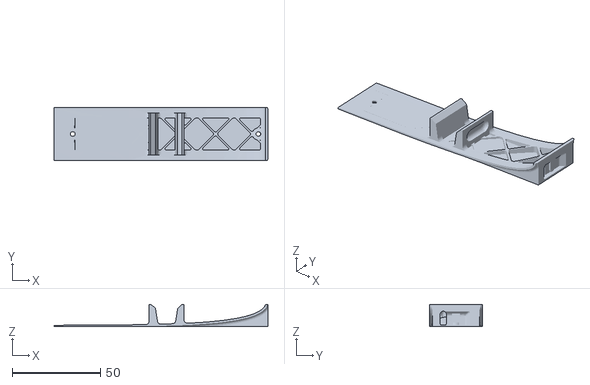
[picture p91: CAD file, 2023-05-08]
Design 2/Design Review Package/Final Design Review Package/Schematics/STLs/Tilt_Motor_Mount_4235323/files/MiniTalonSubMount.stl
121.0 x 30.0 x 12.6
