conrad907/DCADesign/Design 2/Design Review Package/Final Design Review Package/Schematics/STLs/bdy clip spacer.STL

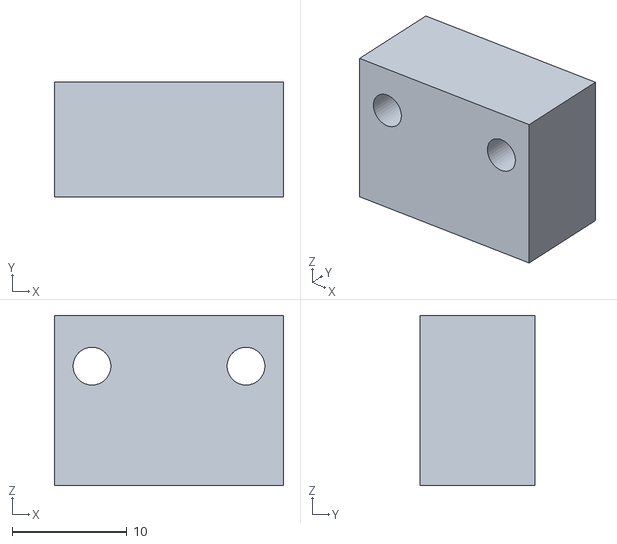
[picture p95: CAD file, 2023-05-08]
Design 2/Design Review Package/Final Design Review Package/Schematics/STLs/bdy clip spacer.STL
20.0 x 10.0 x 14.9
