conrad907/DCADesign/Design 2/Design Review Package/Final Design Review Package/Schematics/STLs/vtol round wing rod holder.STL

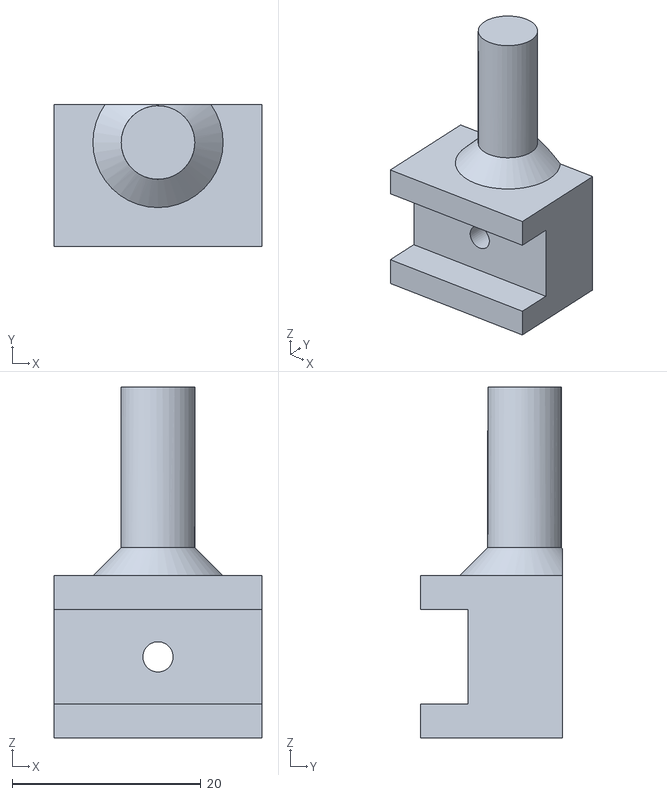
[picture p96: CAD file, 2023-05-08]
Design 2/Design Review Package/Final Design Review Package/Schematics/STLs/vtol round wing rod holder.STL
22.0 x 15.0 x 37.2
