conrad907/DCADesign/Design 2/Design Review Package/Final Design Review Package/Schematics/STLs/H armV5.STL

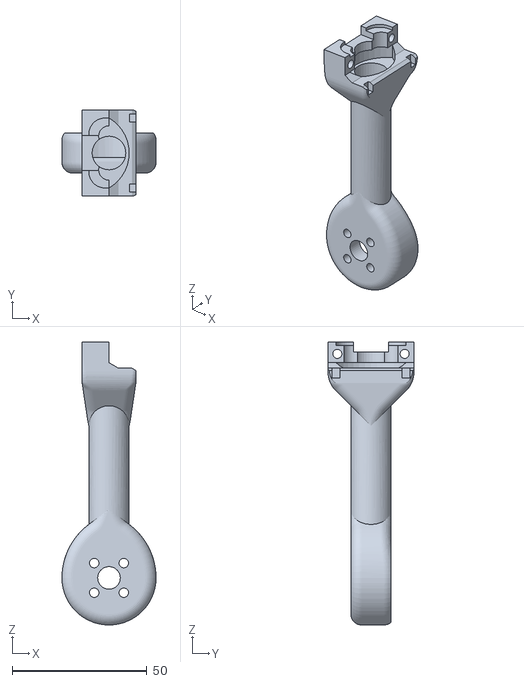
[picture p97: CAD file, 2023-05-08]
Design 2/Design Review Package/Final Design Review Package/Schematics/STLs/H armV5.STL
35.0 x 32.0 x 105.2
