conrad907/DCADesign/Design 2/Design Review Package/Final Design Review Package/Schematics/STLs/vtol Bx_wing.STL

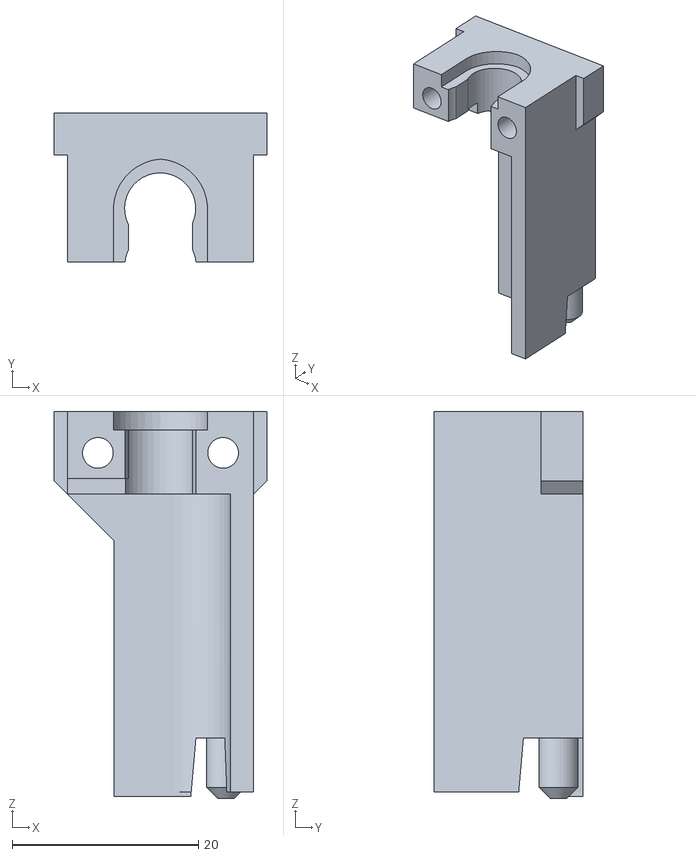
[picture p99: CAD file, 2023-05-08]
Design 2/Design Review Package/Final Design Review Package/Schematics/STLs/vtol Bx_wing.STL
22.8 x 16.0 x 41.6
