conrad907/DCADesign/Design 2/Design Review Package/Final Design Review Package/Schematics/STLs/vtol v3_round wing rod holder.STL

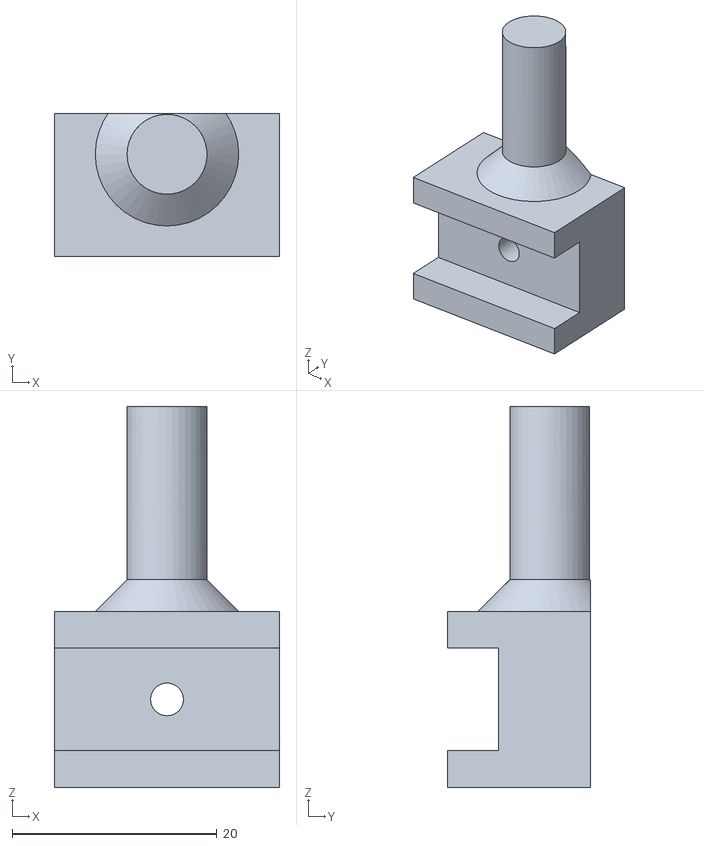
[picture p100: CAD file, 2023-05-08]
Design 2/Design Review Package/Final Design Review Package/Schematics/STLs/vtol v3_round wing rod holder.STL
22.0 x 14.0 x 37.2
