conrad907/DCADesign/Design 2/Design Review Package/Final Design Review Package/Schematics/STLs/vtol WB spacer.STL

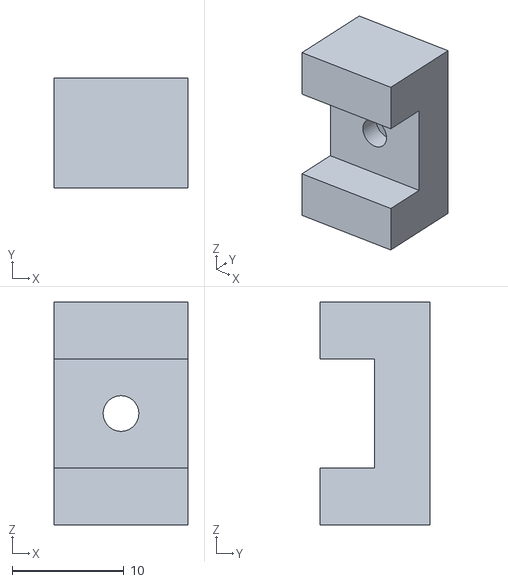
[picture p101: CAD file, 2023-05-08]
Design 2/Design Review Package/Final Design Review Package/Schematics/STLs/vtol WB spacer.STL
12.0 x 9.90 x 20.0
