conrad907/DCADesign/(list of files, cad)

Other CAD files:
Design 2/Design Review Package/Final Design Review Package/Schematics/STLs/vtol B_wing-Combine1.STL
Design 2/Design Review Package/Final Design Review Package/Schematics/STLs/Tilt_Motor_Mount_4235323/files/BoltWasher.stl
Design 2/Design Review Package/Final Design Review Package/Schematics/STLs/Tilt_Motor_Mount_4235323/files/LeadingEdgeBoltWasher.stl
Design 2/Design Review Package/Final Design Review Package/Schematics/STLs/vtol BTM plate v7.STL
Design 2/Design Review Package/Final Design Review Package/Schematics/STLs/vtol TOP plate v7.STL
