conrad907/DCADesign/Design 2/Design Review Package/Critical Design Review Package/Schematics/Airframe Solidworks Measurements.png

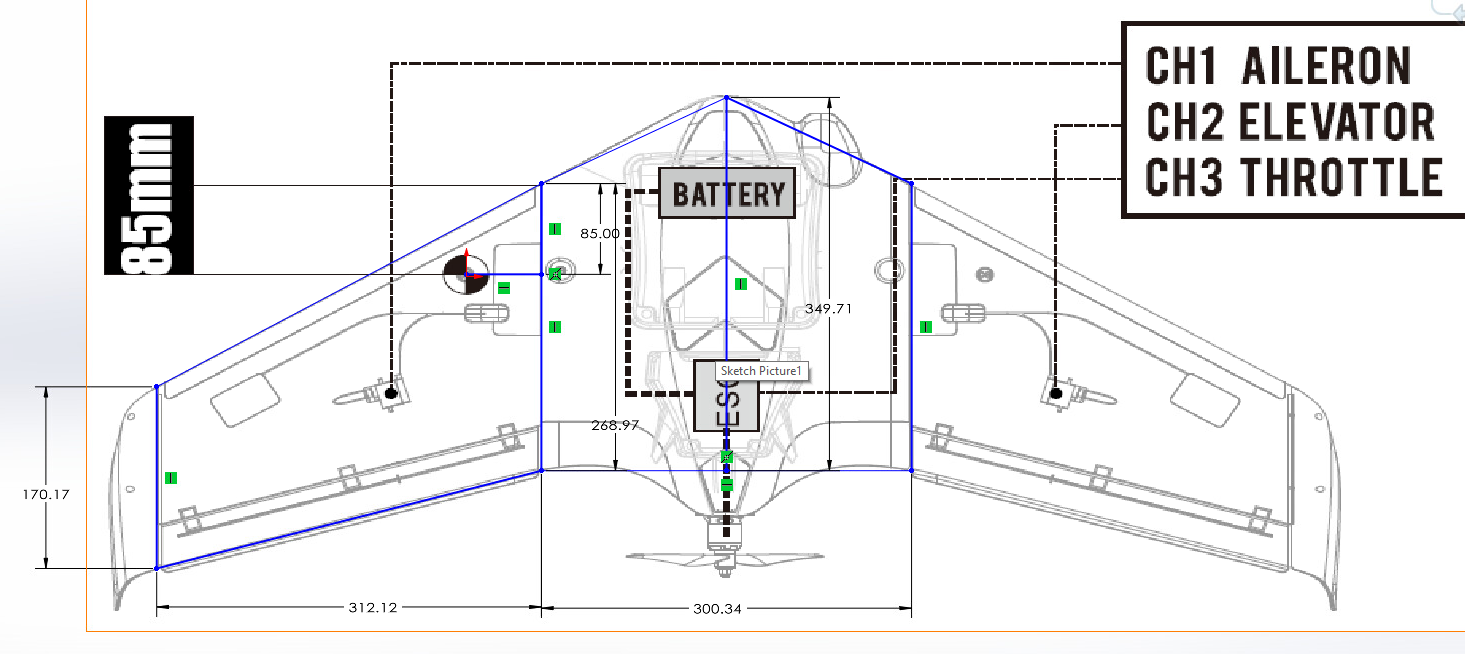
Design 2/Design Review Package/Critical Design Review Package/Schematics/Airframe Solidworks Measurements.png
