conrad907/DCADesign/Design 1/Assignments/Functional Block Diagram.drawio (1).pdf

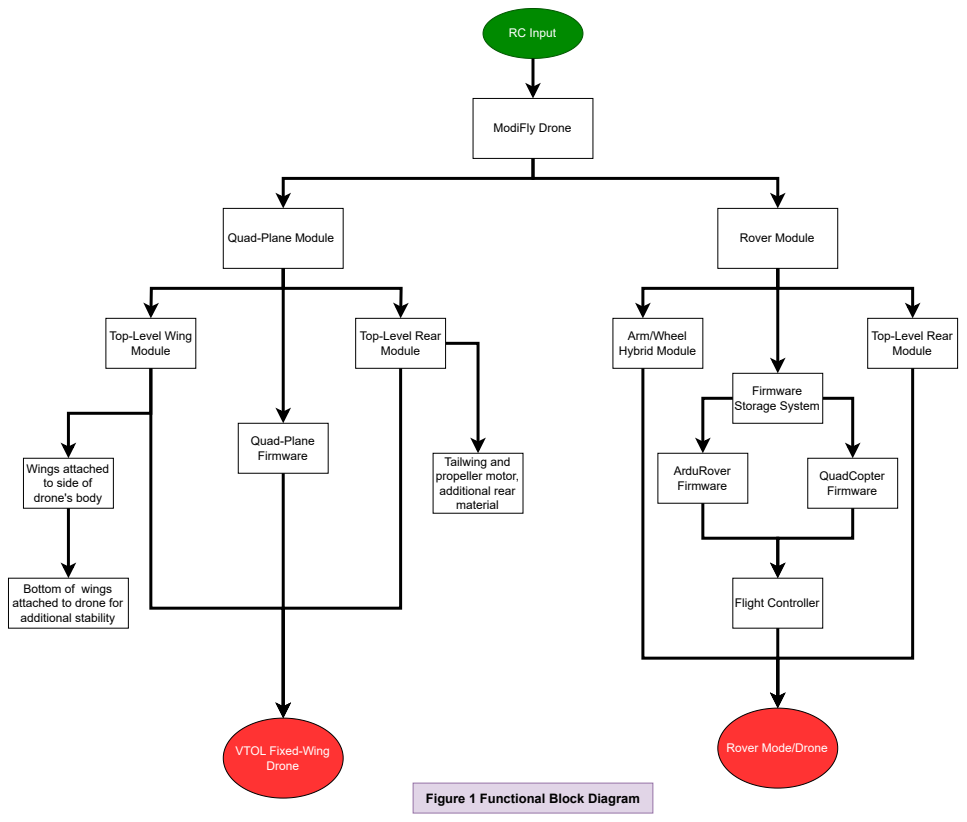
[picture p103: page 1]
ModiFly Drone; RC Input; Quad-Plane Module; Rover Module; Tailwing and propeller motor, additional rear material; Arm/Wheel Hybrid Module; ArduRover Firmware; QuadCopter Firmware; Flight Controller

Top-Level Wing
Module

Top-Level Rear

Firmware Storage System

Quad-Plane Firmware

Wings attached
to side of
drone's body

Bottom of wings
attached to drone for
additional stability

VTOL Fixed-Wing
Drone

Rover Mode/Drone

Figure 1 Functional Block Diagram
