conrad907/DCADesign/Design 1/Assignments/QuadPlane SLD.drawio (1).pdf

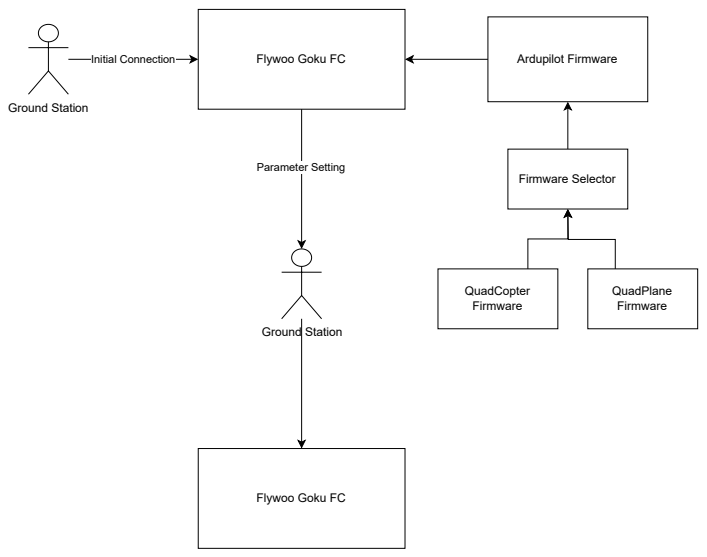
[picture p104: page 1]
Parameter Setting; Initial Connection; Flywoo Goku FC; Ground Station; Ardupilot Firmware; QuadCopter Firmware; QuadPlane Firmware; Firmware Selector

Flywoo Goku FC
