conrad907/DCADesign/Design 1/Assignments/Software FlowChart.drawio (1).pdf

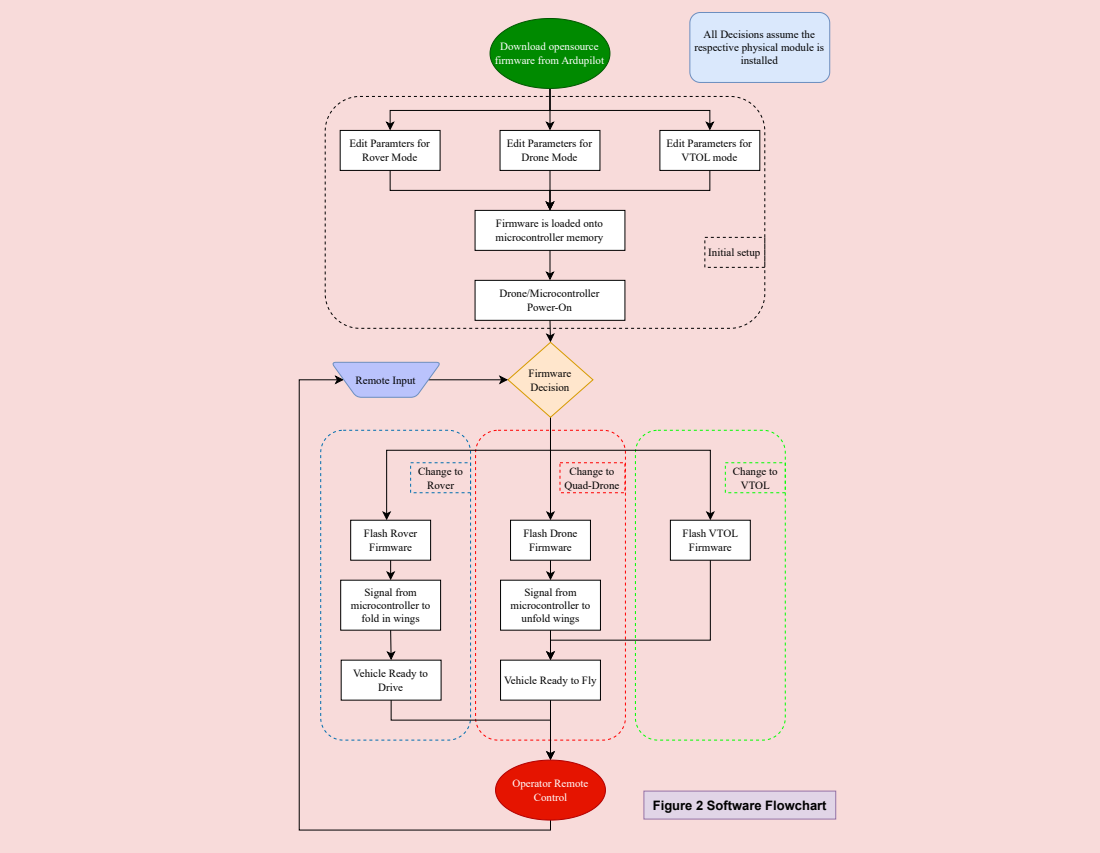
[picture p105: page 1]
Drone/Microcontroller Power-On; Firmware Decision; Flash Rover Firmware; Flash VTOL Firmware; Flash Drone Firmware; Change to VTOL; Change to Quad-Drone; Change to Rover; Signal from microcontroller to unfold wings; installed; Initial setup; Remote Input; Operator Remote; Control; Figure 2 Software Flowchart

All Decisions assume the
respective physical module is

Download opensource
firmware from Ardupilot

Edit Paramters for
Rover Mode

Edit Parameters for
Drone Mode

VTOL mode

Firmware is loaded onto
microcontroller memory

Signal from
microcontroller to
fold in wings

Vehicle Ready to
Drive

Vehicle Ready to Fly
