conrad907/DCADesign/Design 2/Design Review Package/Final Design Review Package/Code/vtol_1.param

BATT_MONITOR,0
BATT2_MONITOR,0
BATT3_MONITOR,0
BATT4_MONITOR,0
BATT5_MONITOR,0
BATT6_MONITOR,0
BATT7_MONITOR,0
BATT8_MONITOR,0
BATT9_MONITOR,0
FLTMODE_CH,8
FLTMODE1,17
FLTMODE2,11
FLTMODE3,5
FLTMODE4,0
FLTMODE5,0
FLTMODE6,5
INS_GYRO_FILTER,20
INS_HNTCH_ENABLE,0
Q_A_ACCEL_P_MAX,40000
Q_A_ACCEL_R_MAX,40000
Q_A_ACCEL_Y_MAX,10000
Q_A_ANG_LIM_TC,1
Q_A_ANG_PIT_P,4.5
Q_A_ANG_RLL_P,4.5
Q_A_ANG_YAW_P,4.5
Q_A_ANGLE_BOOST,1
Q_A_INPUT_TC,0.2
Q_A_RAT_PIT_D,0.0036
Q_A_RAT_PIT_FF,0
Q_A_RAT_PIT_FLTD,10
Q_A_RAT_PIT_FLTE,0
Q_A_RAT_PIT_FLTT,20
Q_A_RAT_PIT_I,0.25
Q_A_RAT_PIT_IMAX,0.5
Q_A_RAT_PIT_P,0.25
Q_A_RAT_PIT_SMAX,50
Q_A_RAT_RLL_D,0.0036
Q_A_RAT_RLL_FF,0
Q_A_RAT_RLL_FLTD,10
Q_A_RAT_RLL_FLTE,0
Q_A_RAT_RLL_FLTT,20
Q_A_RAT_RLL_I,0.25
Q_A_RAT_RLL_IMAX,0.5
Q_A_RAT_RLL_P,0.25
Q_A_RAT_RLL_SMAX,50
Q_A_RAT_YAW_D,0
Q_A_RAT_YAW_FF,0
Q_A_RAT_YAW_FLTD,0
Q_A_RAT_YAW_FLTE,2.5
Q_A_RAT_YAW_FLTT,20
Q_A_RAT_YAW_I,0.018
Q_A_RAT_YAW_IMAX,0.5
Q_A_RAT_YAW_P,0.18
Q_A_RAT_YAW_SMAX,50
Q_A_RATE_FF_ENAB,1
Q_A_RATE_P_MAX,75
Q_A_RATE_R_MAX,75
Q_A_RATE_Y_MAX,75
Q_A_SLEW_YAW,6000
Q_A_THR_MIX_MAN,0.1
Q_A_THR_MIX_MAX,0.5
Q_A_THR_MIX_MIN,0.1
Q_M_BAT_CURR_MAX,0
Q_M_BAT_CURR_TC,5
Q_M_BAT_IDX,0
Q_M_BAT_VOLT_MAX,0
Q_M_BAT_VOLT_MIN,0
Q_M_BOOST_SCALE,0
Q_M_HOVER_LEARN,2
Q_M_PWM_MAX,2000
Q_M_PWM_MIN,1000
Q_M_PWM_TYPE,0
Q_M_SAFE_DISARM,0
Q_M_SAFE_TIME,1
Q_M_SLEW_DN_TIME,0
Q_M_SLEW_UP_TIME,0
Q_M_SPIN_ARM,0.1
Q_M_SPIN_MAX,0.95
Q_M_SPIN_MIN,0.15
Q_M_SPOOL_TIME,0.25
Q_M_THST_EXPO,0.65
Q_M_THST_HOVER,0.35
Q_M_YAW_HEADROOM,200
SERIAL0_BAUD,115
SERIAL0_PROTOCOL,2
SERIAL1_BAUD,57
SERIAL1_OPTIONS,0
SERIAL1_PROTOCOL,2
SERIAL2_BAUD,57
SERIAL2_OPTIONS,0
SERIAL2_PROTOCOL,2
SERIAL3_BAUD,38
SERIAL3_OPTIONS,0
SERIAL3_PROTOCOL,5
SERIAL4_BAUD,38
SERIAL4_OPTIONS,0
SERIAL4_PROTOCOL,5
SERIAL5_BAUD,57
SERIAL5_OPTIONS,0
SERIAL5_PROTOCOL,-1
SERVO1_FUNCTION,33
SERVO1_MAX,1900
SERVO1_MIN,1100
SERVO1_REVERSED,0
SERVO1_TRIM,1500
SERVO2_FUNCTION,34
SERVO2_MAX,1900
SERVO2_MIN,1100
SERVO2_REVERSED,0
SERVO2_TRIM,1500
SERVO3_FUNCTION,0
SERVO3_MAX,1900
SERVO3_MIN,1100
SERVO3_REVERSED,0
SERVO3_TRIM,1500
SERVO4_FUNCTION,35
SERVO4_MAX,1900
SERVO4_MIN,1100
SERVO4_REVERSED,0
SERVO4_TRIM,1500
SERVO5_FUNCTION,36
SERVO5_MAX,1900
SERVO5_MIN,1100
SERVO5_REVERSED,0
SERVO5_TRIM,1500
SERVO6_FUNCTION,0
SERVO6_MAX,1900
SERVO6_MIN,1100
SERVO6_REVERSED,0
SERVO6_TRIM,1500
SERVO7_FUNCTION,0
SERVO7_MAX,1900
SERVO7_MIN,1100
SERVO7_REVERSED,0
SERVO7_TRIM,1500
SERVO8_FUNCTION,0
SERVO8_MAX,1900
SERVO8_MIN,1100
SERVO8_REVERSED,0
SERVO8_TRIM,1500
SERVO9_FUNCTION,78
SERVO9_MAX,1900
SERVO9_MIN,1100
SERVO9_REVERSED,0
SERVO9_TRIM,1500
