conrad907/DCADesign/(commit log)

2023-05-06 TSRPs, Design Package 1
    [Weight Tracker.xlsx]
2023-05-07 Design Package with properly sized videos
    [BoltWasher.stl, H armV5.STL, LeadingEdgeBoltWasher.stl, MiniTalonSubMount.stl, MtrMntPivot.stl, PlaneBase.stl, TailsitterBase.stl, Weight Tracker.xlsx]
